NXPHoverGames/MR-KICAD-LIB/README.md

# MR-KICAD-LIB
Mobile Robotics Kicad Library

[How to add parts to KiCad library](https://nxp1.sharepoint.com/teams/13_1/sanda/SAprojects/ItsDemo/_layouts/OneNote.aspx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{2BCBB6BE-1A13-4EB3-B8AA-A23AA9CD01C0}&page-id={D88BF4C9-4BAD-4BB1-8851-3DFD9DD9CD87}&end)
