NXPHoverGames/MR-KICAD-LIB/3dmodels/P6SMB62CA.STEP

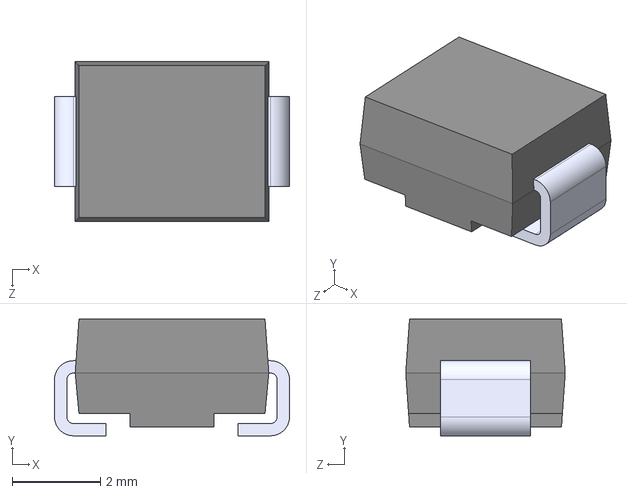
[picture p1: CAD file, 2026-07-27]
3dmodels/P6SMB62CA.STEP
5.34 x 2.65 x 3.62 mm
