NXPHoverGames/MR-KICAD-LIB/3dmodels/NFM15PC104R1A3D.STEP

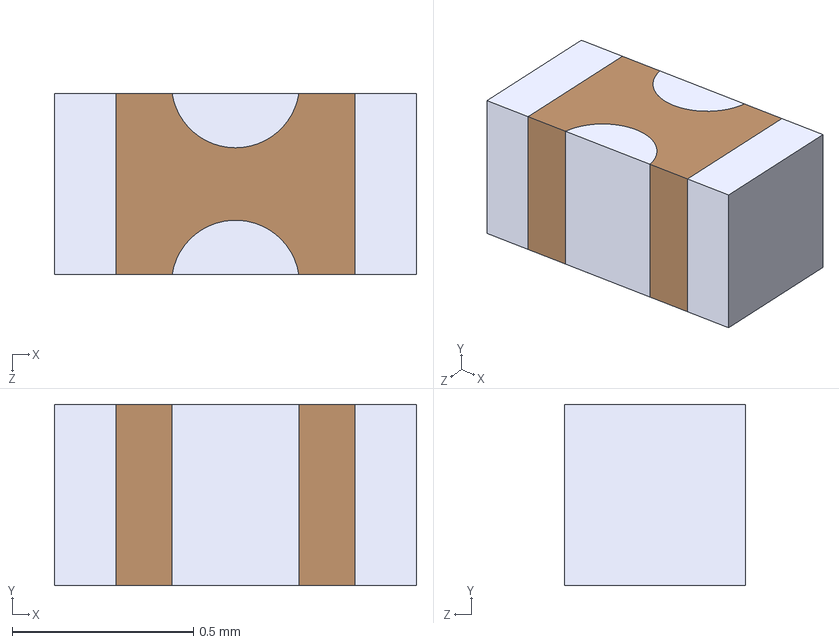
[picture p2: CAD file, 2025-10-23]
3dmodels/NFM15PC104R1A3D.STEP
1.00 x 0.5 x 0.5 mm
