NXPHoverGames/MR-KICAD-LIB/3dmodels/NX138BKMYL.STEP

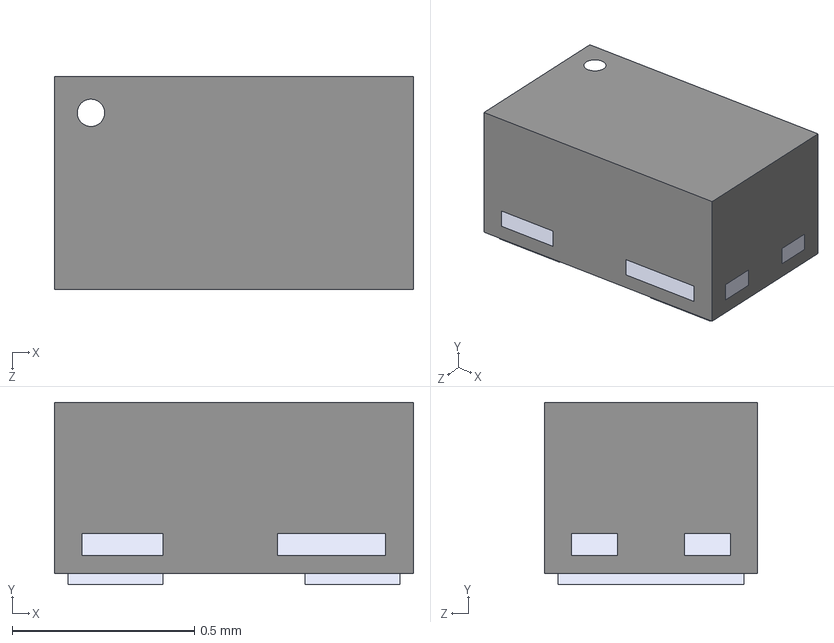
[picture p3: CAD file, 2025-10-23]
3dmodels/NX138BKMYL.STEP
0.985 x 0.5 x 0.585 mm
