NXPHoverGames/MR-KICAD-LIB/3dmodels/CHS-01TA.STEP

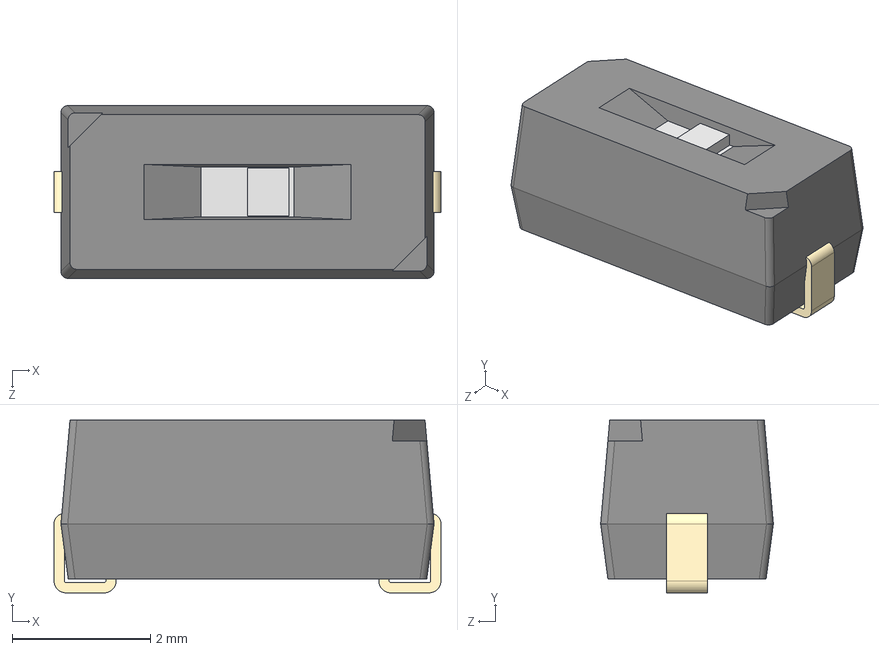
[picture p4: CAD file, 2025-10-23]
3dmodels/CHS-01TA.STEP
5.60 x 2.50 x 2.50 mm
CHS-01 body
pin^CHS-01xx
switch^CHS-01xx
