NXPHoverGames/MR-KICAD-LIB/3dmodels/REF6041IDGKT.stp

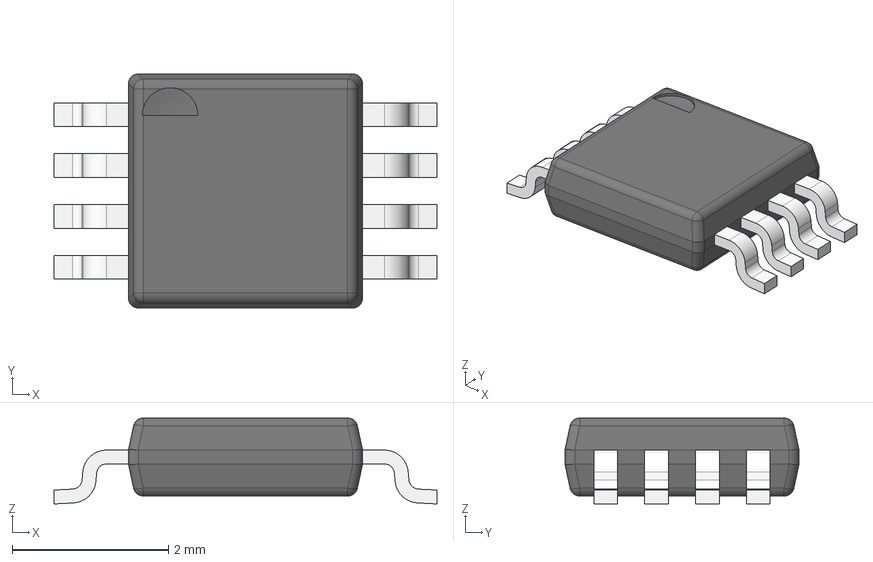
[picture p5: CAD file, 2025-09-09]
3dmodels/REF6041IDGKT.stp
4.90 x 3.00 x 1.10 mm
BODY_MUA08A
LEAD_MUA08A x 8
