NXPHoverGames/MR-KICAD-LIB/3dmodels/THS4551IRGTR.stp

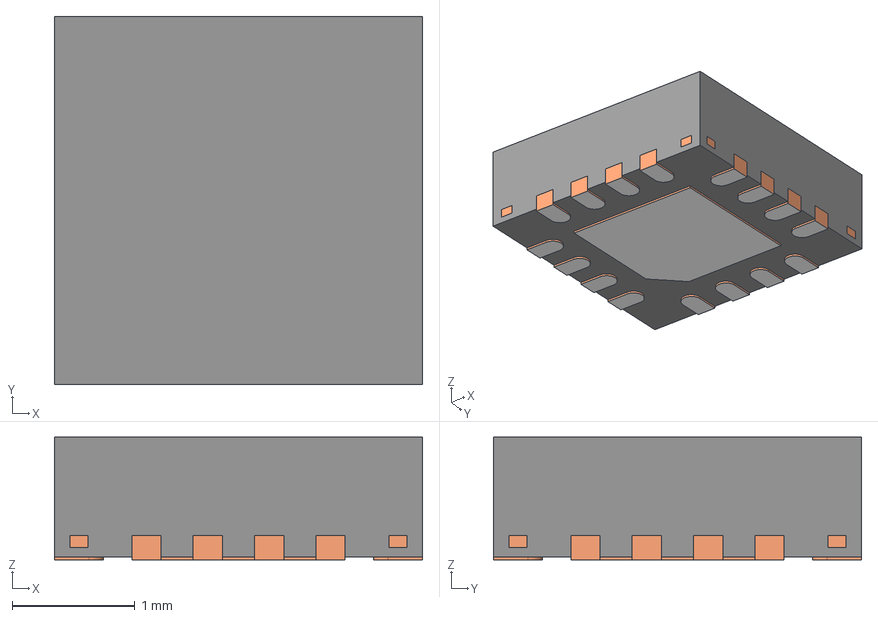
[picture p6: CAD file, 2025-09-09]
3dmodels/THS4551IRGTR.stp
3.00 x 3.00 x 1.00 mm
BODY-QFN
FRAME-RGT0016C
PIN1-ID
