NXPHoverGames/MR-KICAD-LIB/3dmodels/ADS127L18IRSHT.stp

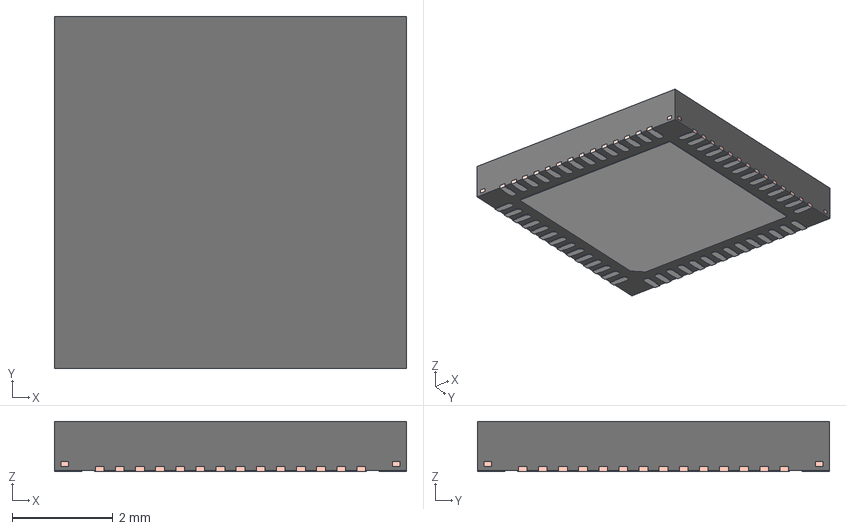
[picture p7: CAD file, 2025-08-08]
3dmodels/ADS127L18IRSHT.stp
7.00 x 7.00 x 1.00 mm
RSH0056G_FRAME
RSH0056G_BODY
RSH0056G_PIN1_AREA
