NXPHoverGames/MR-KICAD-LIB/3dmodels/KRL6432E-M-R003-F-T1.stp

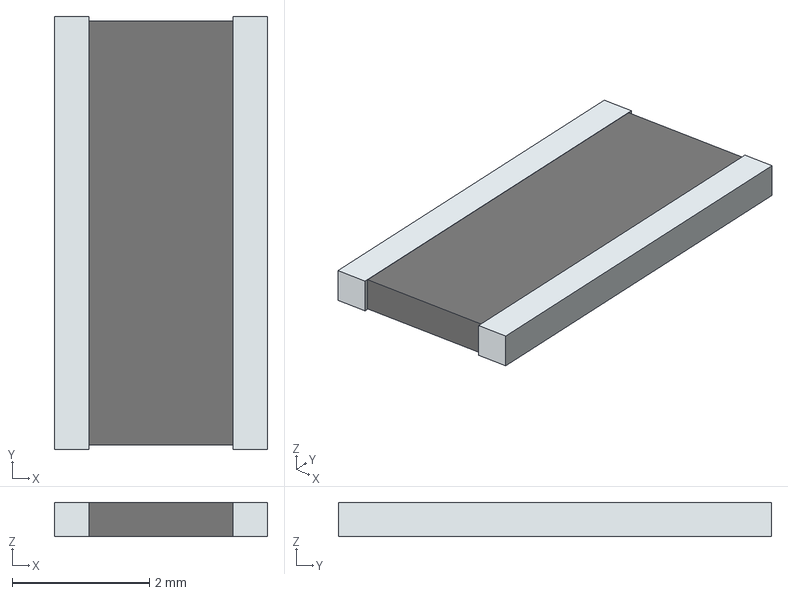
[picture p8: CAD file, 2025-07-31]
3dmodels/KRL6432E-M-R003-F-T1.stp
3.10 x 6.30 x 0.5 mm
term1
term2
