NXPHoverGames/MR-KICAD-LIB/3dmodels/MDT275M02001.stp

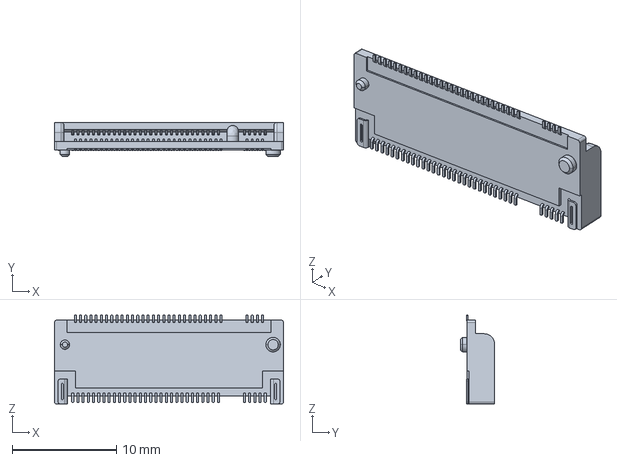
[picture p9: CAD file, 2025-07-31]
3dmodels/MDT275M02001.stp
22.0 x 3.30 x 8.55 mm
