NXPHoverGames/MR-KICAD-LIB/3dmodels/21x21.960-21-21-D-AB-0.STEP

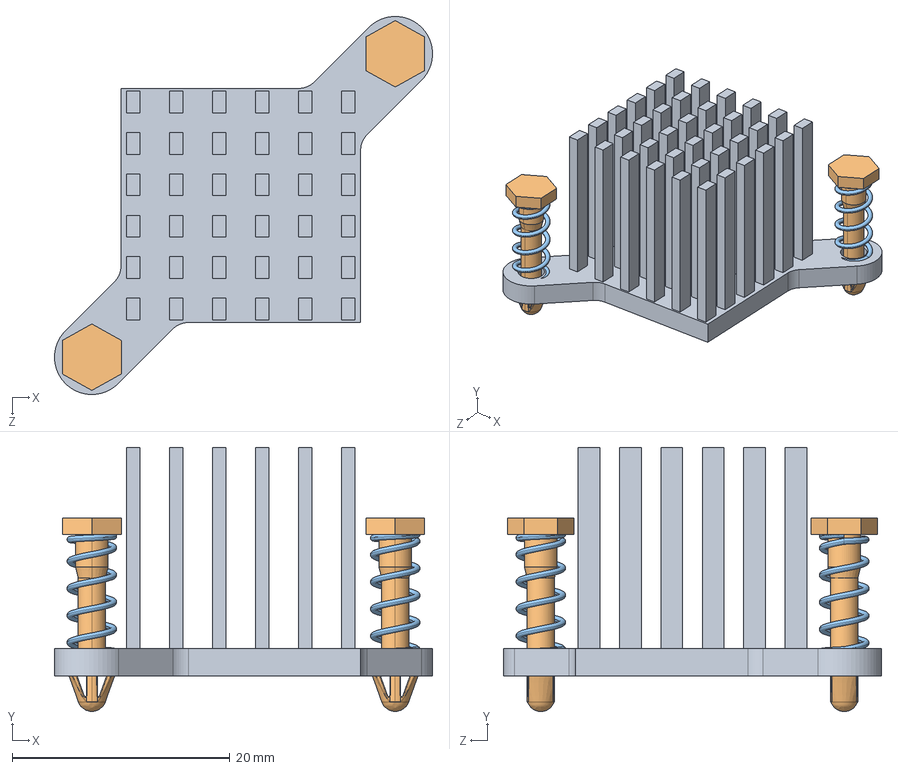
[picture p10: CAD file, 2025-07-31]
3dmodels/21x21.960-21-21-D-AB-0.STEP
34.7 x 24.2 x 34.7 mm
21mm_base_21x21 diag ears
Spring_C0180-022-0440-M x 2
