NXPHoverGames/MR-KICAD-LIB/3dmodels/DF40TC-40DP-0.4V(51).stp

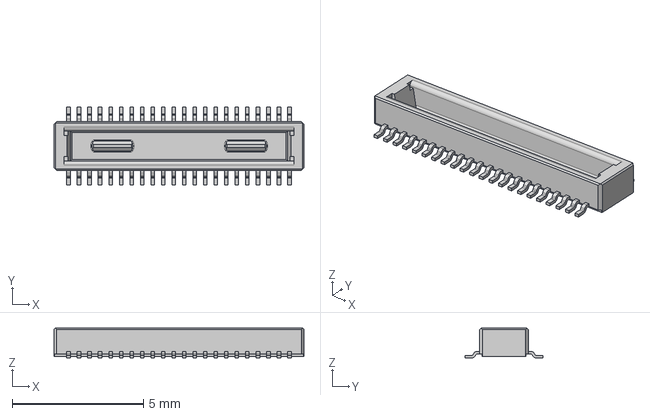
[picture p11: CAD file, 2025-07-31]
3dmodels/DF40TC-40DP-0.4V(51).stp
9.52 x 2.97 x 1.14 mm
