NXPHoverGames/MR-KICAD-LIB/3dmodels/SM10B-SRSS-TB_LF__SN_.stp

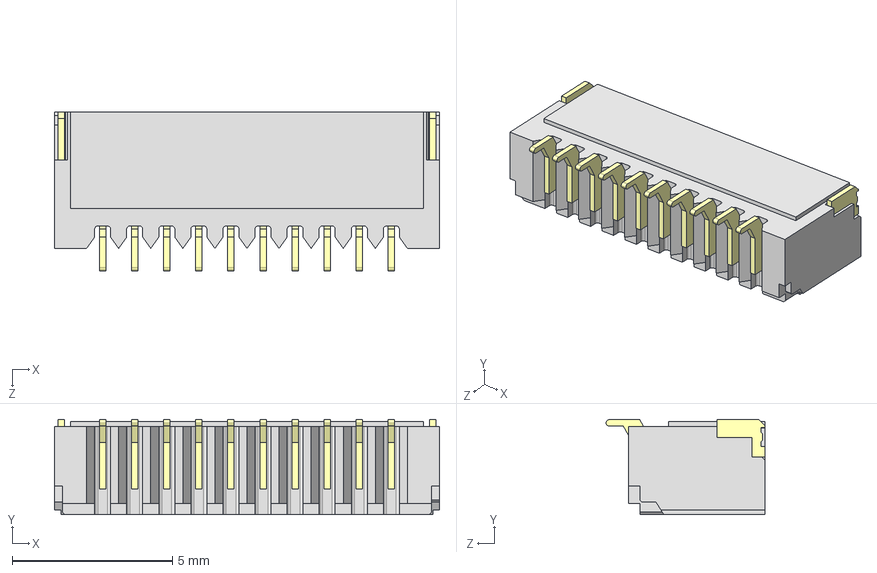
[picture p12: CAD file, 2025-07-31]
3dmodels/SM10B-SRSS-TB_LF__SN_.stp
12.0 x 2.97 x 4.95 mm
