NXPHoverGames/MR-KICAD-LIB/3dmodels/spm4030.step

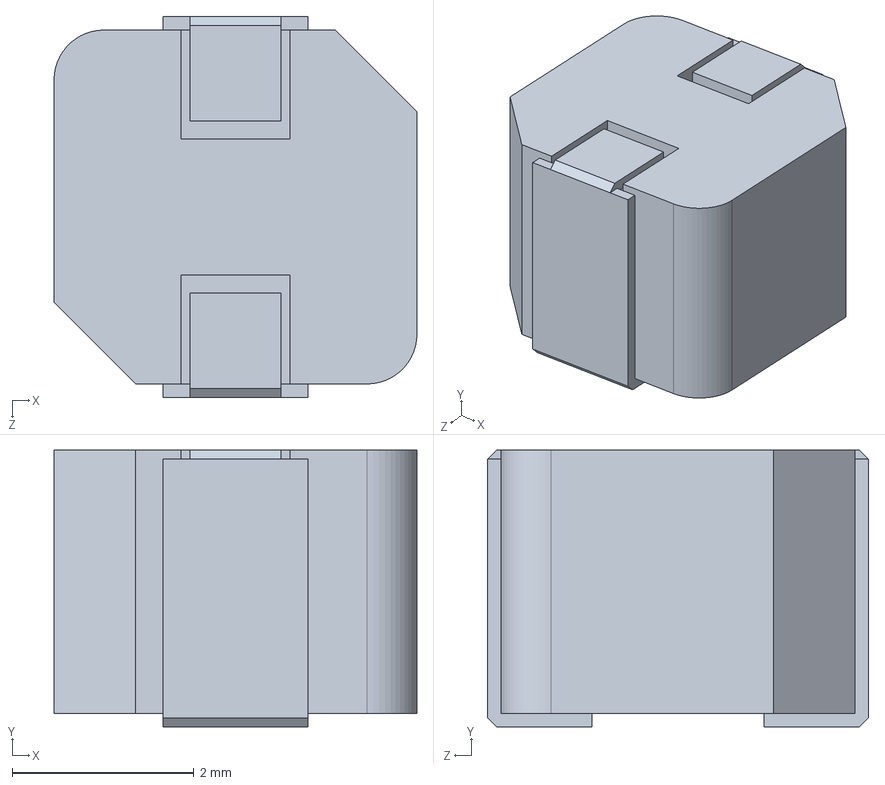
[picture p13: CAD file, 2025-07-31]
3dmodels/spm4030.step
4.00 x 3.05 x 4.20 mm
