NXPHoverGames/MR-KICAD-LIB/3dmodels/EPC2204A.step

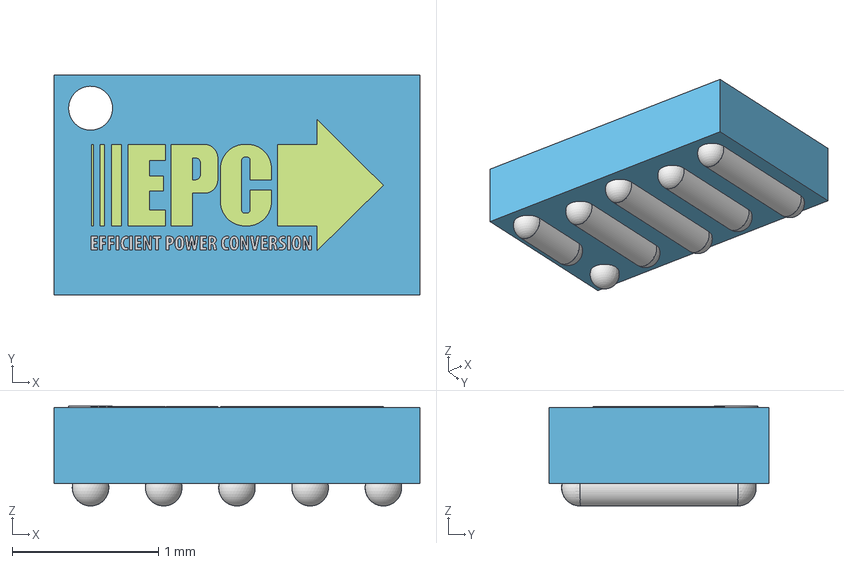
[picture p14: CAD file, 2025-07-31]
3dmodels/EPC2204A.step
2.50 x 1.50 x 0.683 mm
2mm
2mm001
2mm002
2mm003
2mm004
2mm005
2mm006
Extruded
