NXPHoverGames/MR-KICAD-LIB/3dmodels/STEP_61612102121405 (rev1).stp

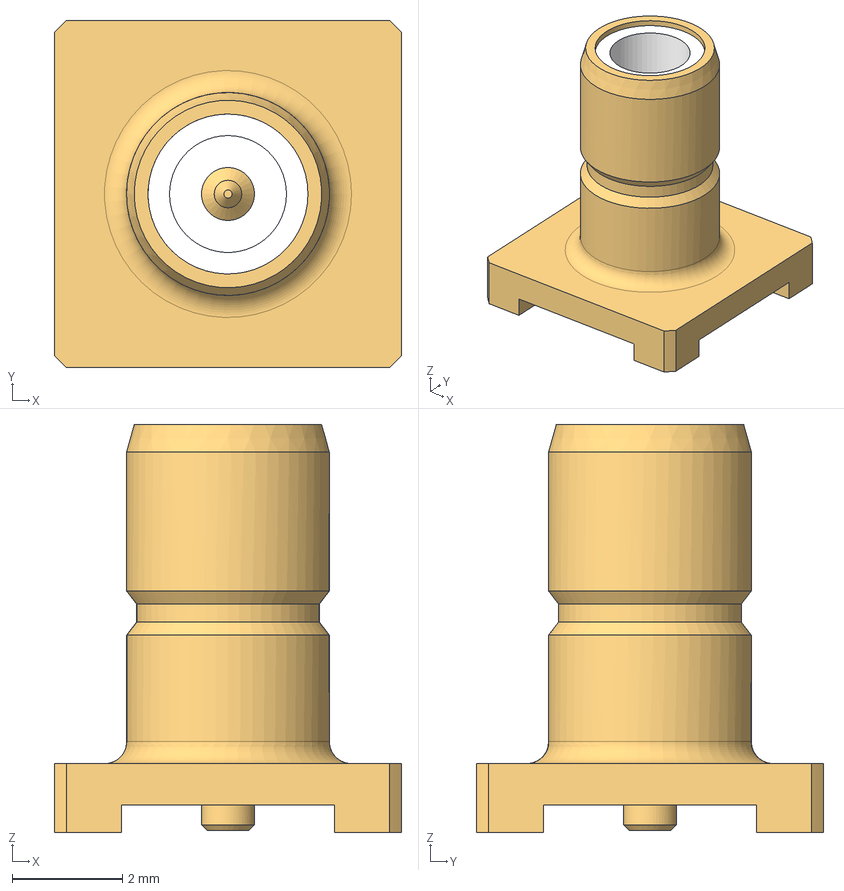
[picture p15: CAD file, 2025-07-31]
3dmodels/STEP_61612102121405 (rev1).stp
6.30 x 6.30 x 7.40 mm
