NXPHoverGames/MR-KICAD-LIB/3dmodels/PESD2IVN24-UX.stp

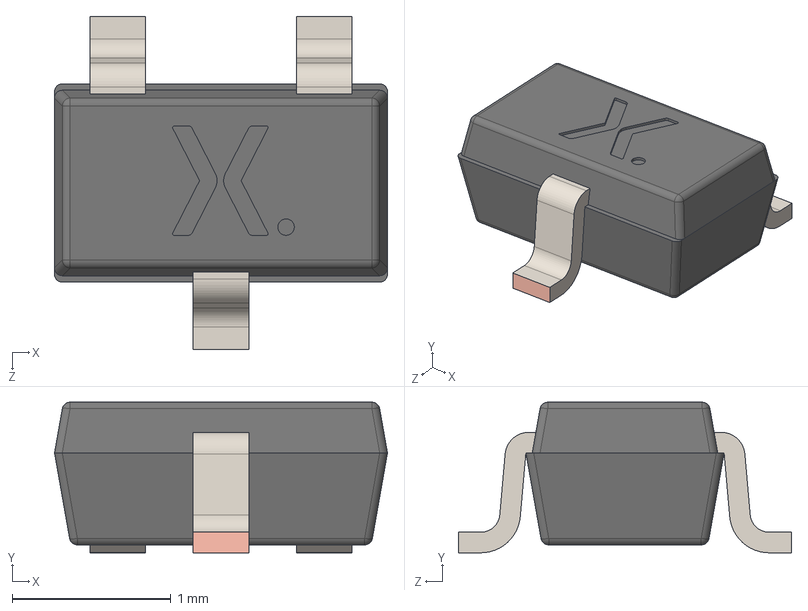
[picture p16: CAD file, 2025-07-31]
3dmodels/PESD2IVN24-UX.stp
2.10 x 0.95 x 2.10 mm
Upper body
lower body
Lead x 3
