NXPHoverGames/MR-KICAD-LIB/3dmodels/TCR3UF20A_LM_CT.step

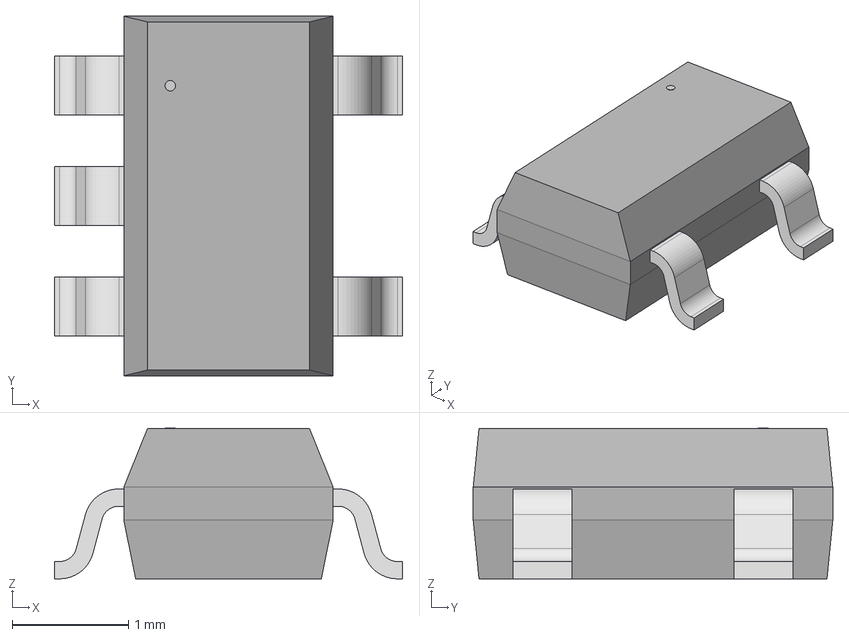
[picture p17: CAD file, 2025-07-31]
3dmodels/TCR3UF20A_LM_CT.step
3.00 x 3.10 x 1.30 mm
