NXPHoverGames/MR-KICAD-LIB/3dmodels/PCMF1USB3SZ.stp

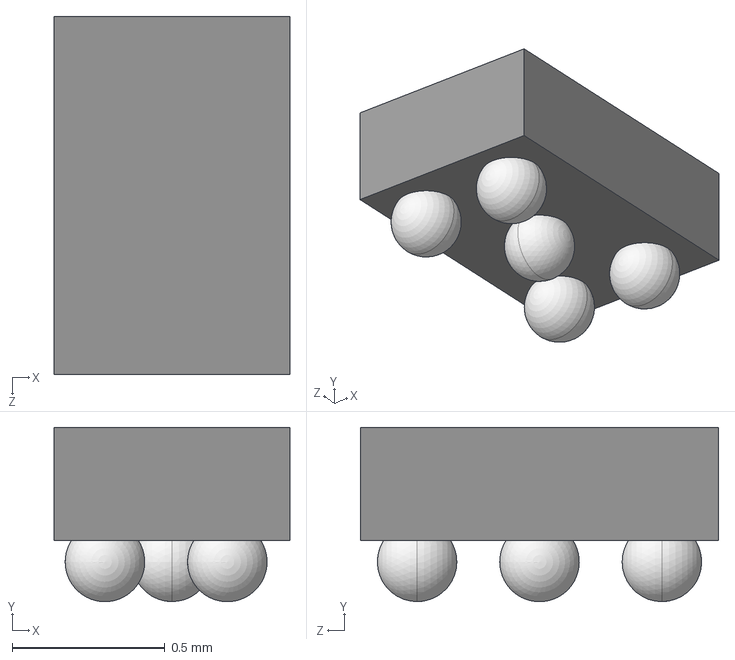
[picture p18: CAD file, 2025-07-31]
3dmodels/PCMF1USB3SZ.stp
0.77 x 0.57 x 1.17 mm
