NXPHoverGames/MR-KICAD-LIB/3dmodels/SIR626LDP-T1-RE3.stp

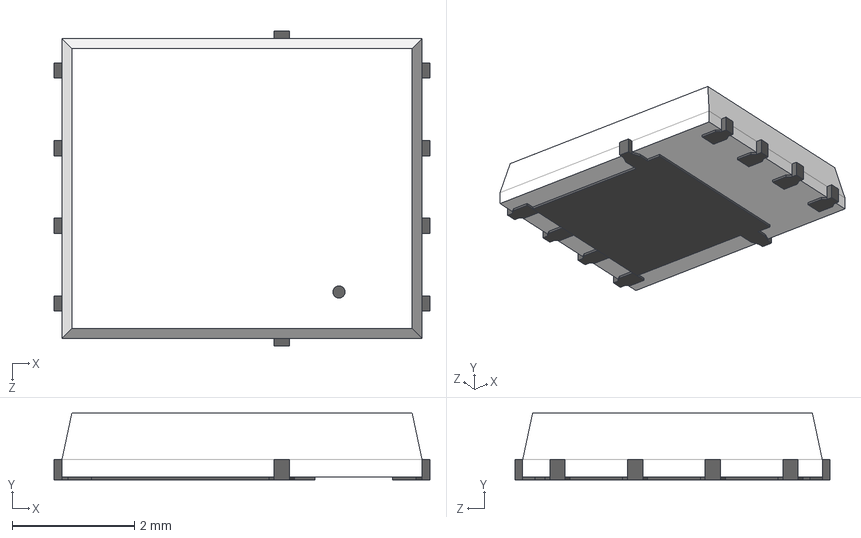
[picture p19: CAD file, 2025-07-31]
3dmodels/SIR626LDP-T1-RE3.stp
6.15 x 1.09 x 5.15 mm
