NXPHoverGames/MR-KICAD-LIB/3dmodels/PG-TSDSON-8-25_Z8B00157108_V02_3D.stp

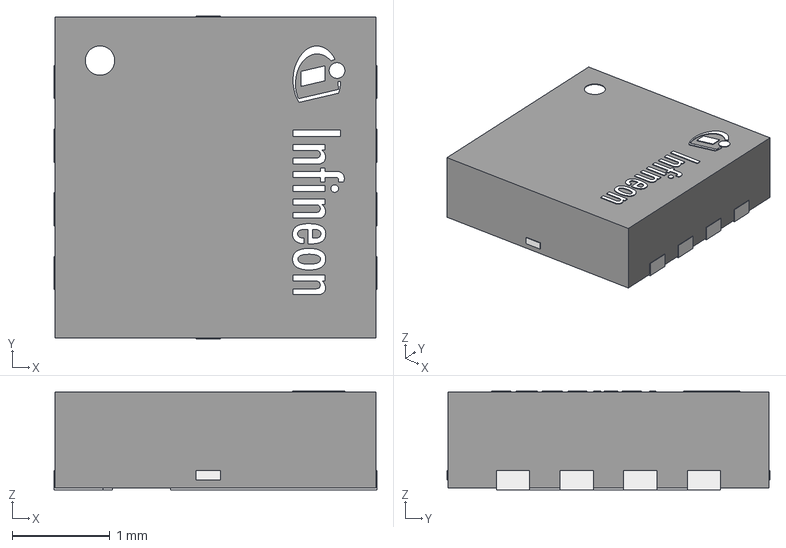
[picture p20: CAD file, 2025-07-31]
3dmodels/PG-TSDSON-8-25_Z8B00157108_V02_3D.stp
3.30 x 3.30 x 1.01 mm
