NXPHoverGames/MR-KICAD-LIB/3dmodels/DF40TC-40DS-0.4V_58_.stp

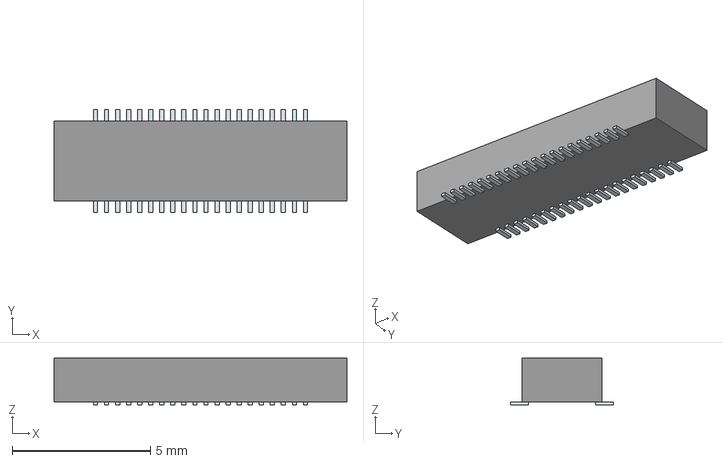
[picture p21: CAD file, 2025-07-31]
3dmodels/DF40TC-40DS-0.4V_58_.stp
10.6 x 3.74 x 1.70 mm
Pins
