NXPHoverGames/MR-KICAD-LIB/3dmodels/LM5143QRHARQ1.stp

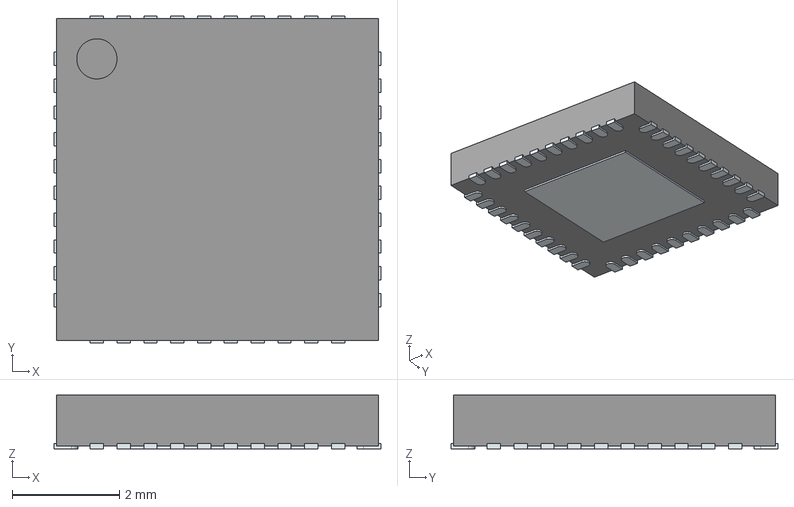
[picture p22: CAD file, 2025-07-31]
3dmodels/LM5143QRHARQ1.stp
6.10 x 6.10 x 1.00 mm
ThermalPin
PinsArrayLR
PinsArrayTB
