NXPHoverGames/MR-KICAD-LIB/3dmodels/XRCGB25M000F3A00R0.stp

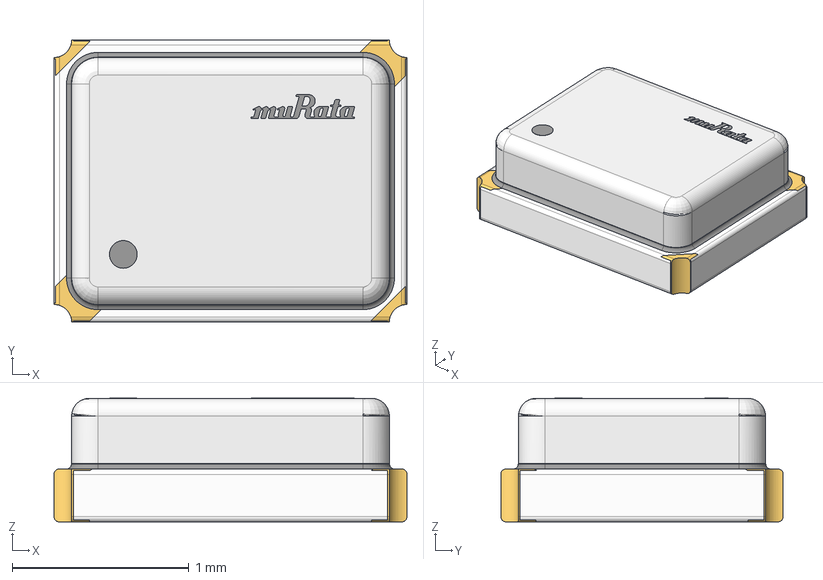
[picture p24: CAD file, 2025-07-31]
3dmodels/XRCGB25M000F3A00R0.stp
2.00 x 1.60 x 0.702 mm
