NXPHoverGames/MR-KICAD-LIB/3dmodels/6DFN62CA-M3_I.stp

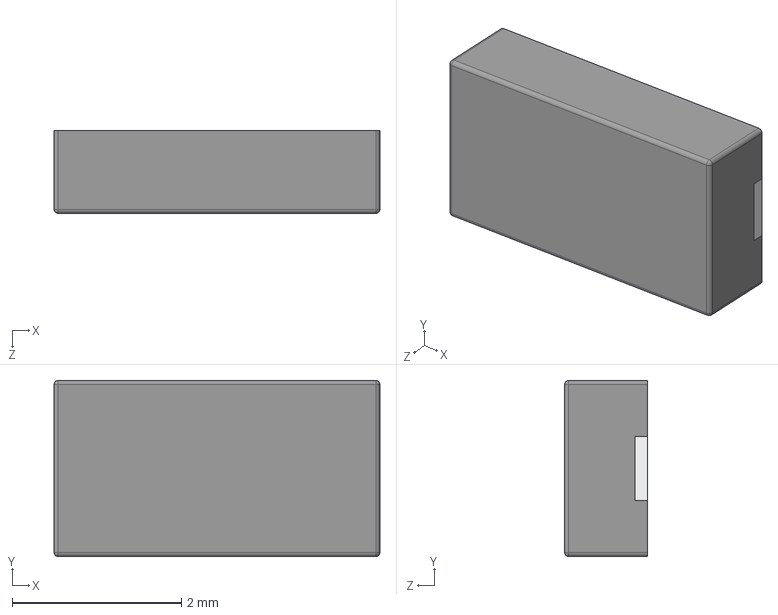
[picture p25: CAD file, 2025-07-31]
3dmodels/6DFN62CA-M3_I.stp
3.85 x 2.08 x 0.98 mm
