NXPHoverGames/MR-KICAD-LIB/3dmodels/F32Q-1A7H1-11022.stp

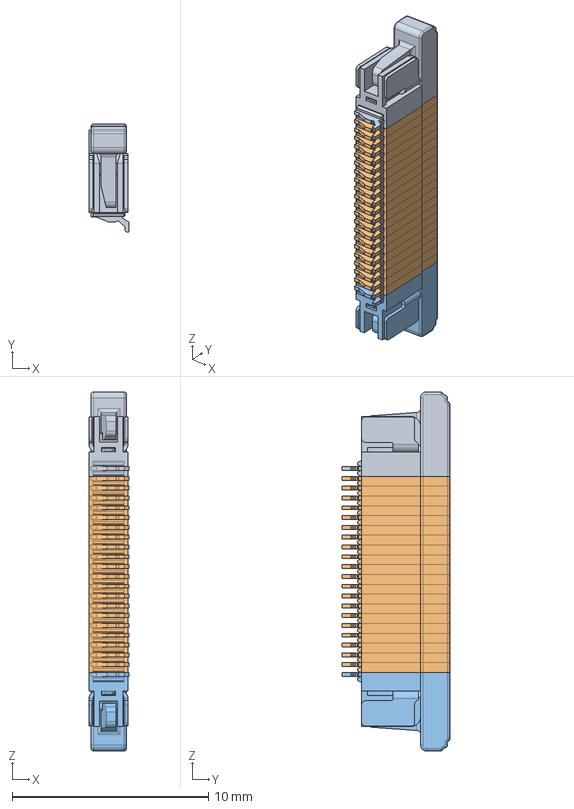
[picture p26: CAD file, 2025-07-31]
3dmodels/F32Q-1A7H1-11022.stp
2.05 x 5.50 x 18.3 mm
F32Q_L
F32Q_M x 20
F32Q_R
