NXPHoverGames/MR-KICAD-LIB/3dmodels/MIC5504-1.8YMT-TR.step

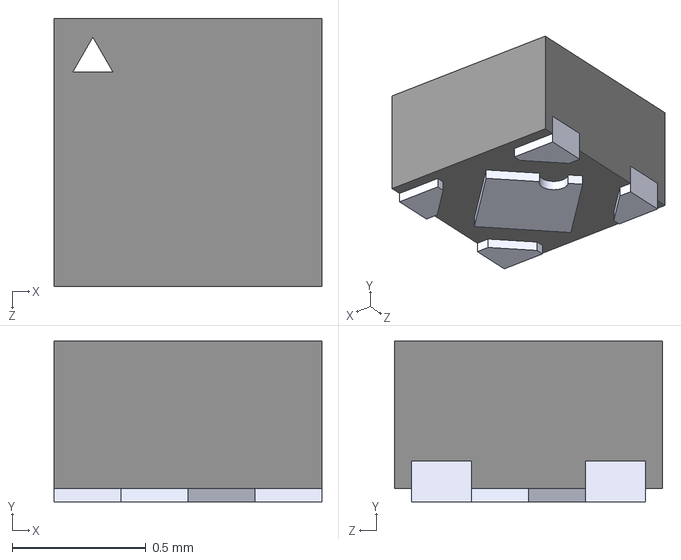
[picture p27: CAD file, 2025-07-31]
3dmodels/MIC5504-1.8YMT-TR.step
1.00 x 0.6 x 1.00 mm
