NXPHoverGames/MR-KICAD-LIB/3dmodels/1-1734248-5.stp

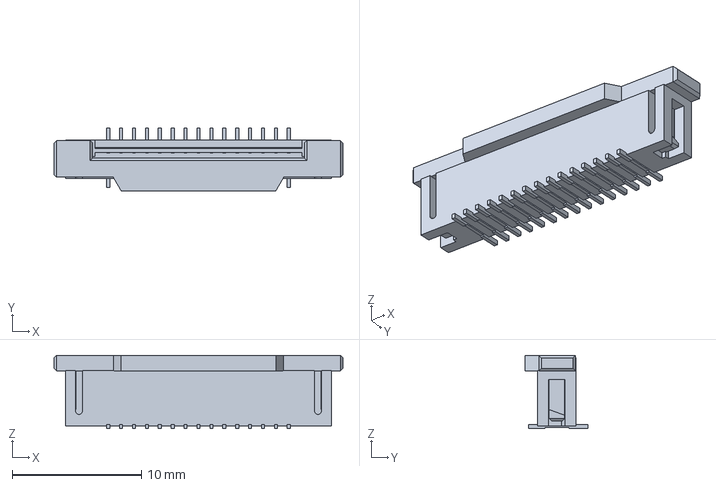
[picture p28: CAD file, 2025-07-31]
3dmodels/1-1734248-5.stp
22.4 x 4.85 x 5.68 mm
