NXPHoverGames/MR-KICAD-LIB/3dmodels/NX5P3363UKZ.stp

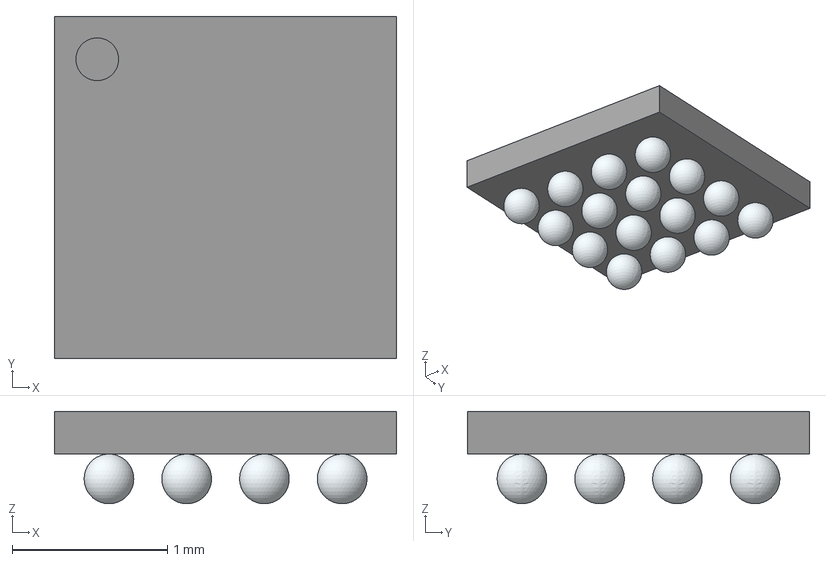
[picture p29: CAD file, 2025-07-31]
3dmodels/NX5P3363UKZ.stp
2.20 x 2.20 x 0.595 mm
