NXPHoverGames/MR-KICAD-LIB/3dmodels/NANOT160AS.stp

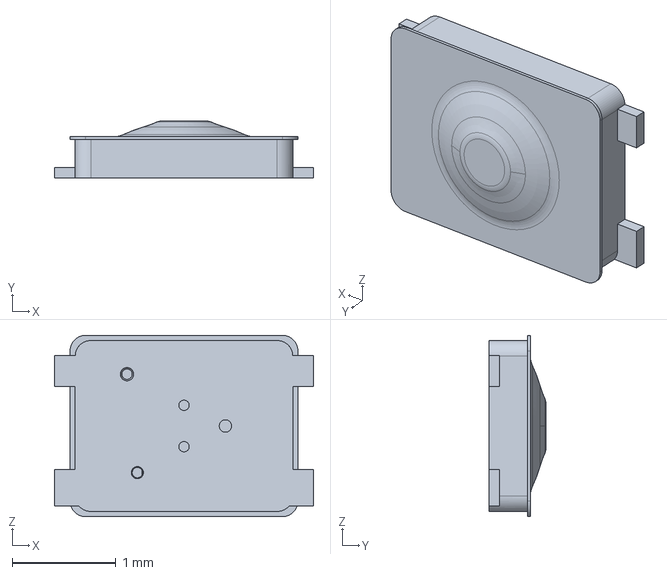
[picture p30: CAD file, 2025-07-31]
3dmodels/NANOT160AS.stp
2.50 x 0.55 x 1.75 mm
