NXPHoverGames/MR-KICAD-LIB/3dmodels/PCMF3USB3S_CZ.stp

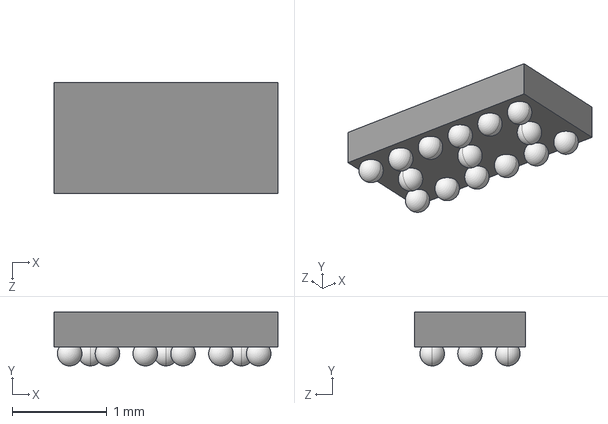
[picture p31: CAD file, 2025-07-31]
3dmodels/PCMF3USB3S_CZ.stp
2.37 x 0.57 x 1.17 mm
