NXPHoverGames/MR-KICAD-LIB/3dmodels/MPM3822CGRH.step

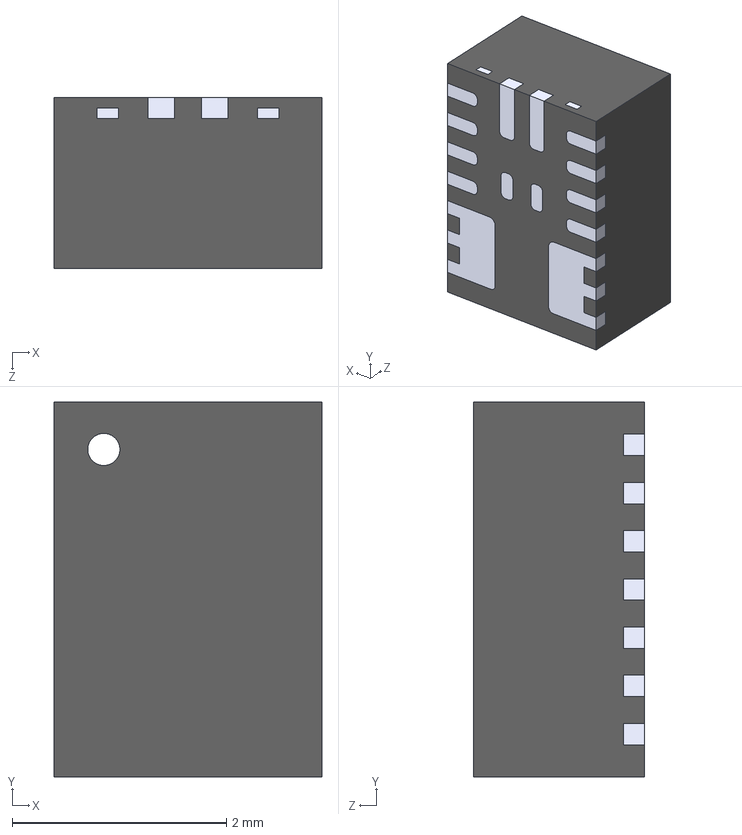
[picture p32: CAD file, 2025-07-31]
3dmodels/MPM3822CGRH.step
2.50 x 3.50 x 1.60 mm
