NXPHoverGames/MR-KICAD-LIB/3dmodels/TJA1051TK.step

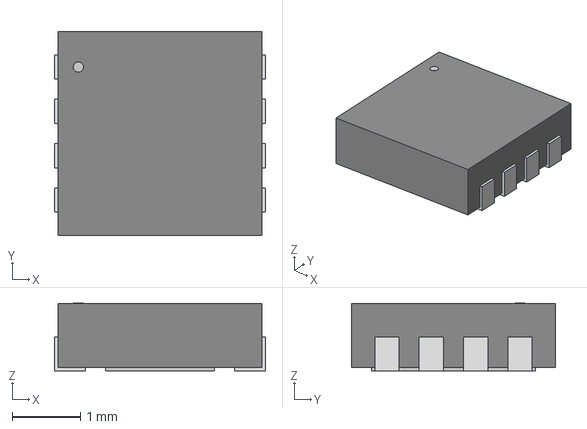
[picture p34: CAD file, 2025-07-31]
3dmodels/TJA1051TK.step
3.10 x 3.00 x 0.993 mm
