NXPHoverGames/MR-KICAD-LIB/3dmodels/SM06B-GHS-TB_LF__SN_.stp

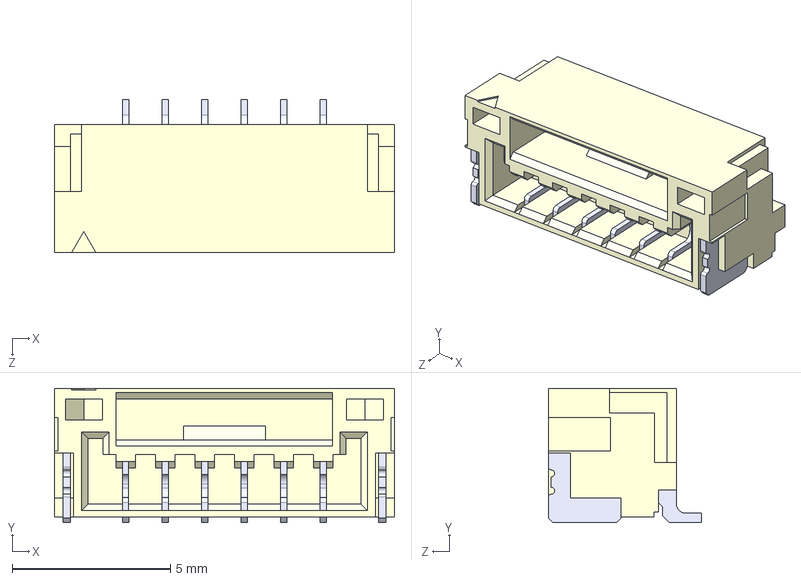
[picture p35: CAD file, 2025-07-31]
3dmodels/SM06B-GHS-TB_LF__SN_.stp
10.8 x 4.25 x 4.85 mm
