NXPHoverGames/MR-KICAD-LIB/3dmodels/AMS29D-40MZ5-Z.stp

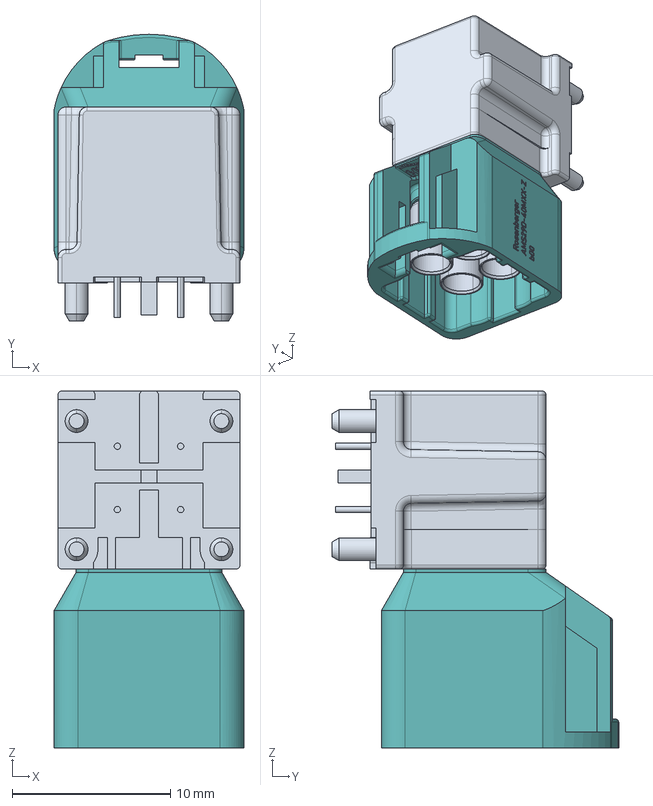
[picture p36: CAD file, 2025-07-31]
3dmodels/AMS29D-40MZ5-Z.stp
12.0 x 18.1 x 22.6 mm
