NXPHoverGames/MR-KICAD-LIB/3dmodels/ICM-42688-P0.step

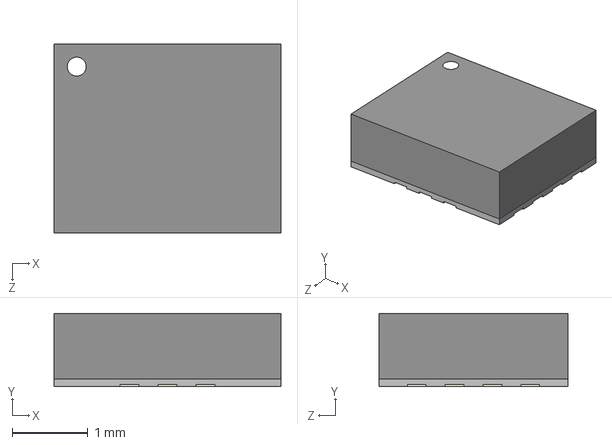
[picture p37: CAD file, 2025-07-31]
3dmodels/ICM-42688-P0.step
3.00 x 0.97 x 2.50 mm
