NXPHoverGames/MR-KICAD-LIB/3dmodels/Infineon-PG-TDSON-8-45_3D_01_STP-Package-v14_00-EN.stp

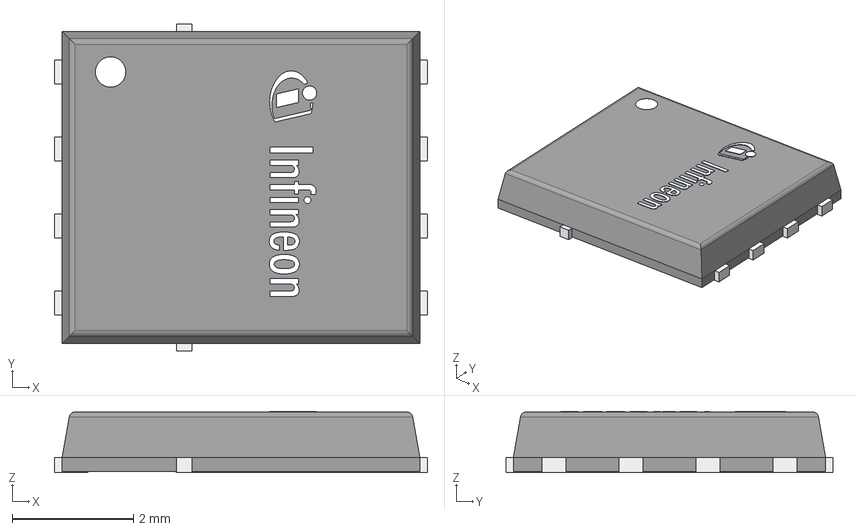
[picture p38: CAD file, 2025-07-31]
3dmodels/Infineon-PG-TDSON-8-45_3D_01_STP-Package-v14_00-EN.stp
6.15 x 5.39 x 1.01 mm
