NXPHoverGames/MR-KICAD-LIB/3dmodels/VQFN32_PHA_MCH.step

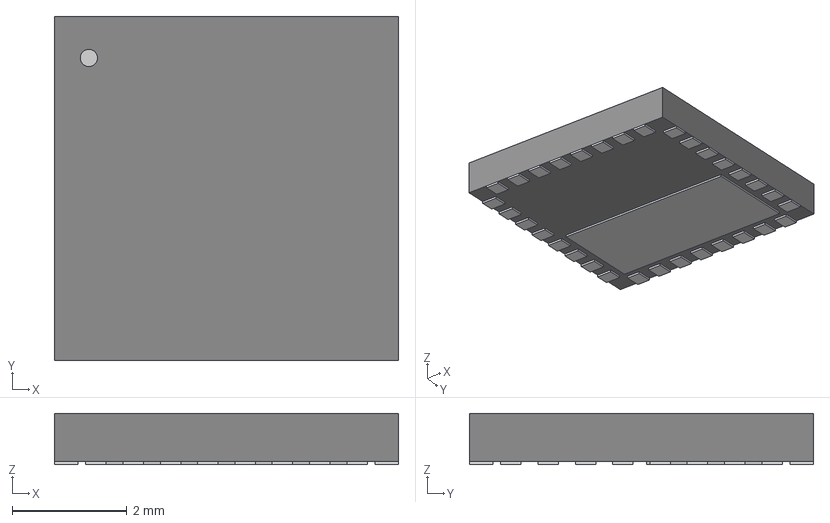
[picture p39: CAD file, 2025-07-31]
3dmodels/VQFN32_PHA_MCH.step
5.99 x 5.99 x 0.892 mm
