NXPHoverGames/MR-KICAD-LIB/3dmodels/DF40TC_3.0_-40DS-0.4V_58_.stp

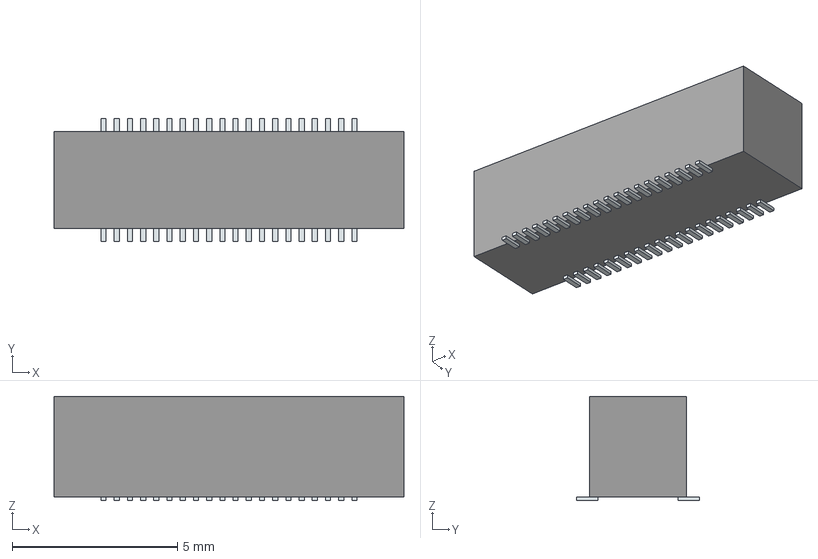
[picture p40: CAD file, 2025-07-31]
3dmodels/DF40TC_3.0_-40DS-0.4V_58_.stp
10.6 x 3.74 x 3.15 mm
Pins
