NXPHoverGames/MR-KICAD-LIB/3dmodels/TSW-108-08-T-T-RA_SAI.step

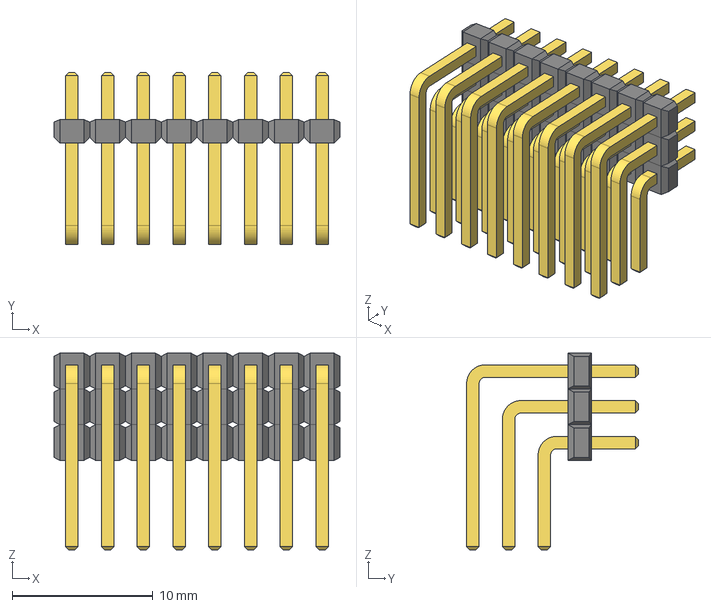
[picture p42: CAD file, 2025-07-31]
3dmodels/TSW-108-08-T-T-RA_SAI.step
20.3 x 12.2 x 14.0 mm
