NXPHoverGames/MR-KICAD-LIB/3dmodels/10LGA_2X2X0p75_BOS.step

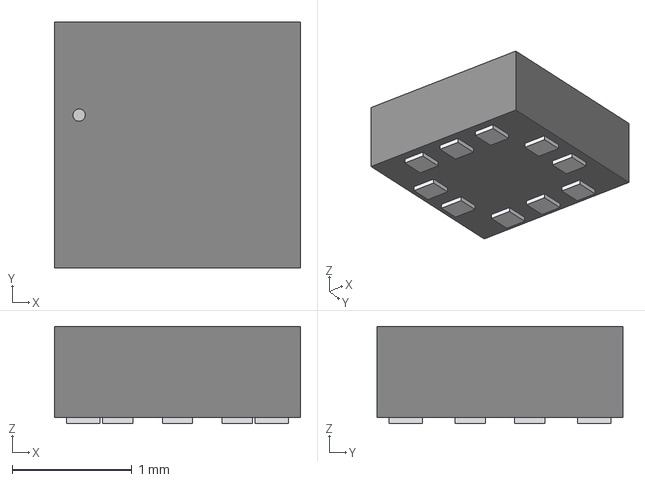
[picture p43: CAD file, 2025-07-31]
3dmodels/10LGA_2X2X0p75_BOS.step
2.06 x 2.06 x 0.815 mm
