NXPHoverGames/MR-KICAD-LIB/3dmodels/BMM350.stp

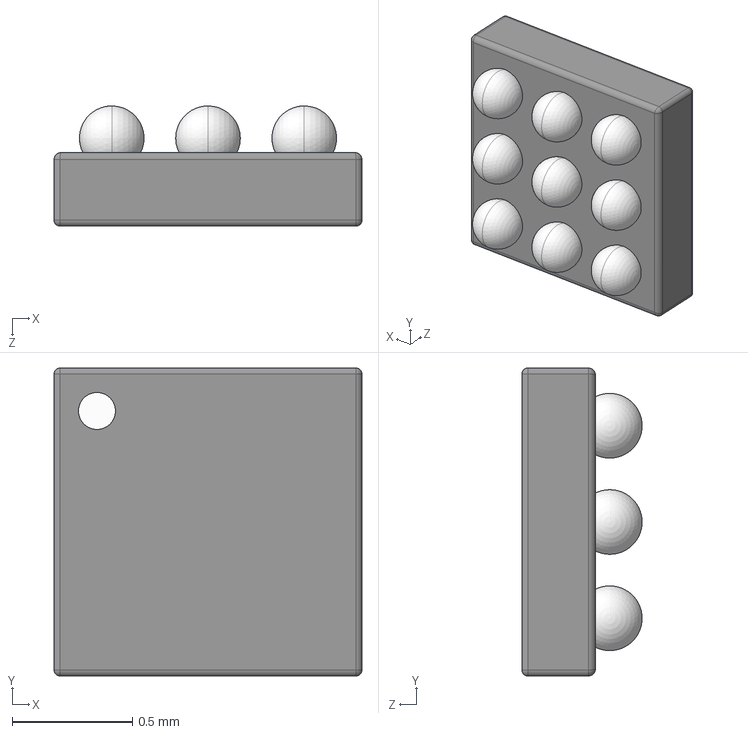
[picture p44: CAD file, 2025-07-31]
3dmodels/BMM350.stp
1.28 x 1.28 x 0.5 mm
