NXPHoverGames/MR-KICAD-LIB/3dmodels/PAA3905E1-Q.STEP

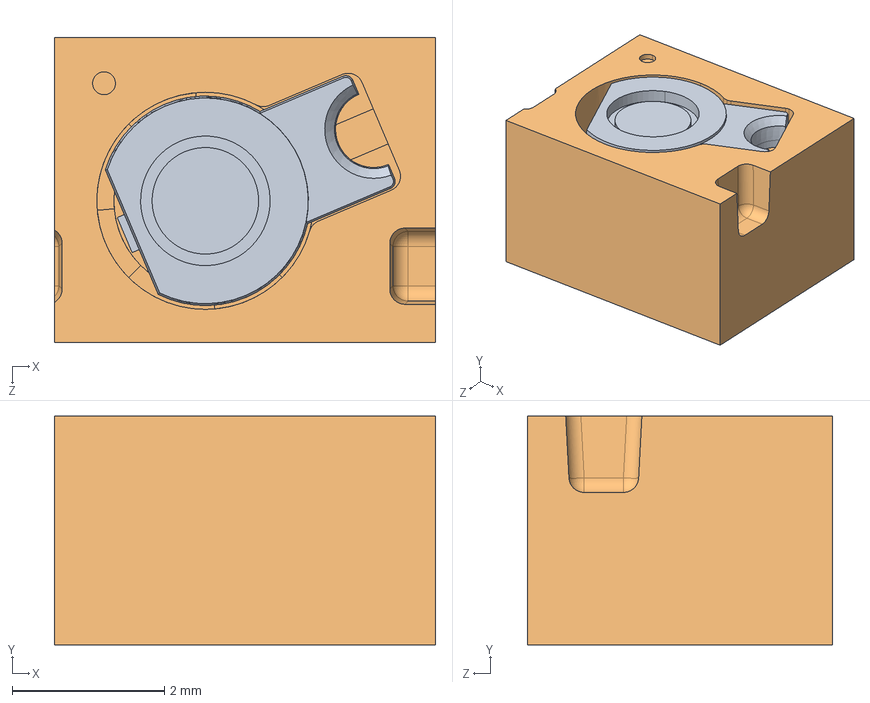
[picture p45: CAD file, 2025-07-31]
3dmodels/PAA3905E1-Q.STEP
5.00 x 3.00 x 4.00 mm
