NXPHoverGames/MR-KICAD-LIB/3dmodels/FH34SRJ-24S-0.5SH_99_.stp

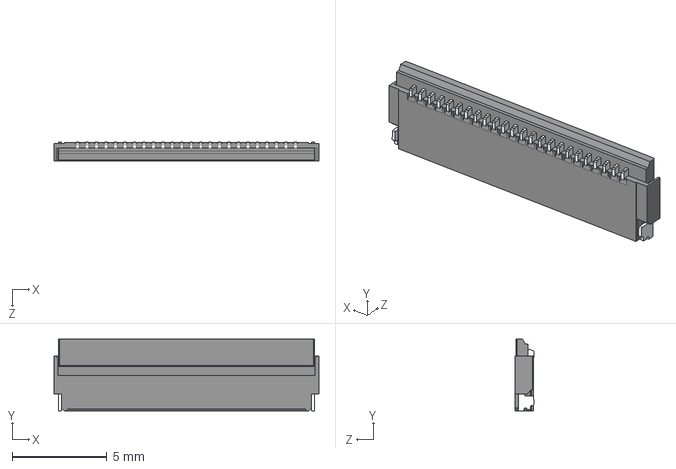
[picture p46: CAD file, 2025-07-31]
3dmodels/FH34SRJ-24S-0.5SH_99_.stp
14.0 x 3.80 x 1.00 mm
