NXPHoverGames/MR-KICAD-LIB/3dmodels/BUK6D56-60EX.stp

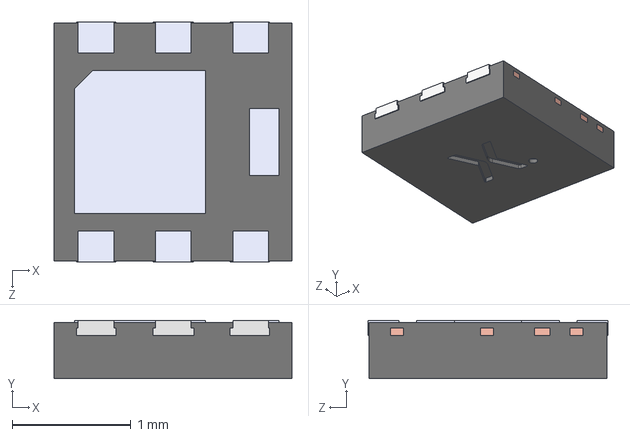
[picture p47: CAD file, 2025-07-31]
3dmodels/BUK6D56-60EX.stp
2.00 x 0.49 x 2.02 mm
SOT1220 Body
SOT1220 Lead
