NXPHoverGames/MR-KICAD-LIB/3dmodels/FKK5R0030FE-TR.stp

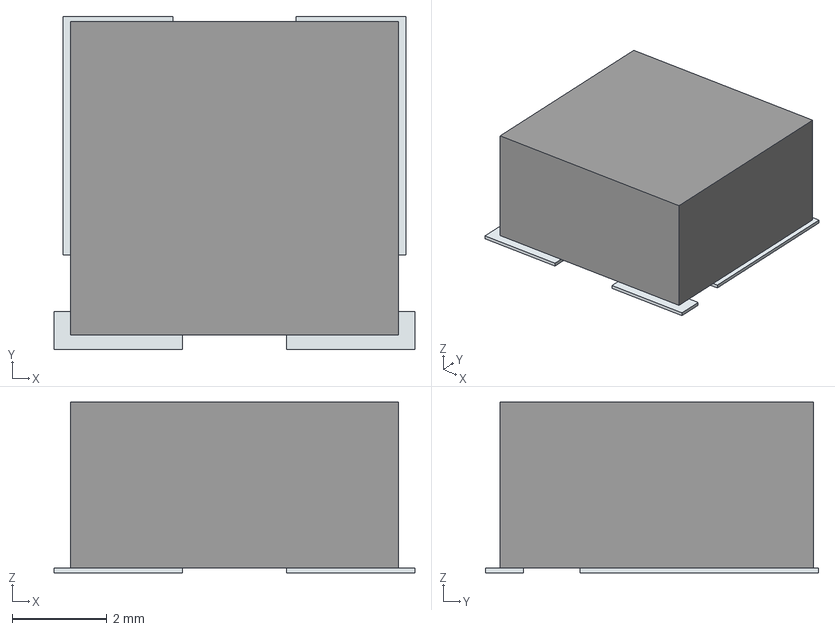
[picture p48: CAD file, 2025-07-31]
3dmodels/FKK5R0030FE-TR.stp
7.60 x 7.01 x 3.60 mm
Pins
