NXPHoverGames/MR-KICAD-LIB/3dmodels/VL53L3CXV0DH.step

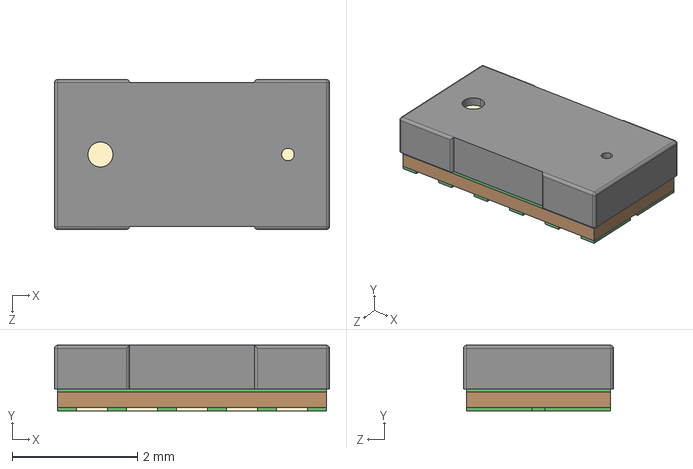
[picture p49: CAD file, 2025-07-31]
3dmodels/VL53L3CXV0DH.step
4.40 x 1.05 x 2.40 mm
