NXPHoverGames/MR-KICAD-LIB/3dmodels/DF40TC(3.0)-50DP-0.4V(51).STEP

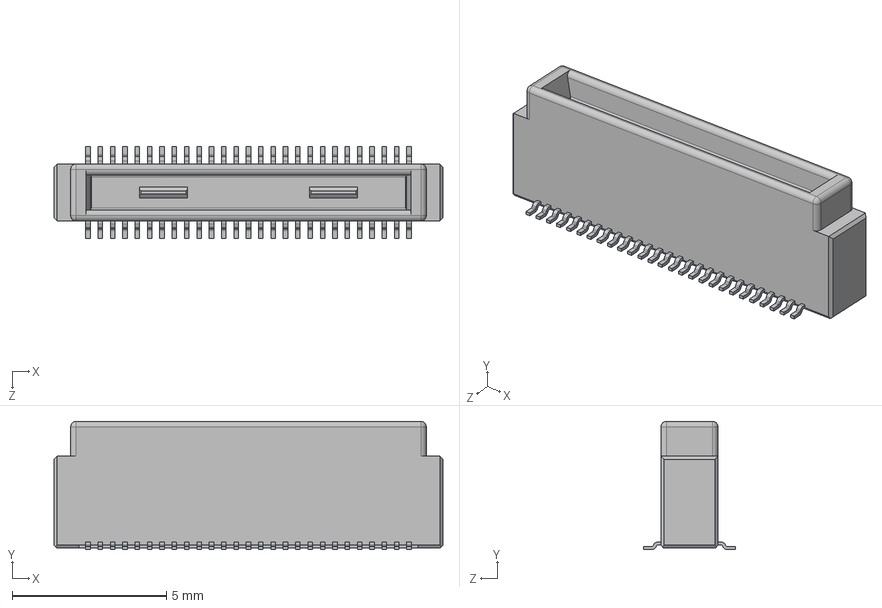
[picture p50: CAD file, 2025-07-31]
3dmodels/DF40TC(3.0)-50DP-0.4V(51).STEP
12.6 x 4.16 x 2.97 mm
