NXPHoverGames/MR-KICAD-LIB/3dmodels/NFM31KC153R1H3L.stp

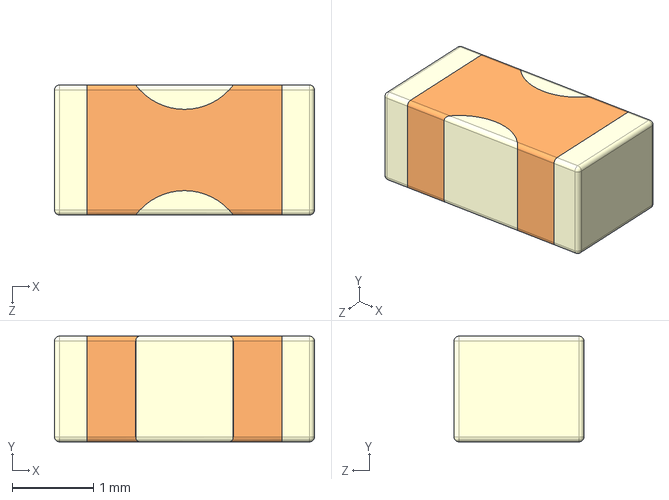
[picture p52: CAD file, 2025-07-31]
3dmodels/NFM31KC153R1H3L.stp
3.20 x 1.30 x 1.60 mm
