NXPHoverGames/MR-KICAD-LIB/3dmodels/VL53L1CXV0FY.step

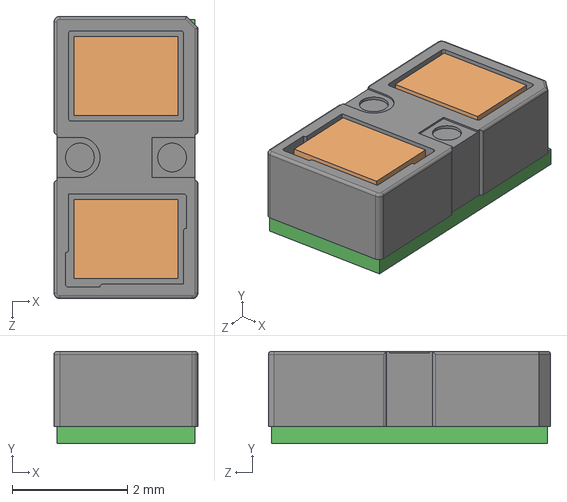
[picture p53: CAD file, 2025-07-31]
3dmodels/VL53L1CXV0FY.step
2.50 x 1.60 x 4.90 mm
