NXPHoverGames/MR-KICAD-LIB/3dmodels/TJA1463ATK.stp

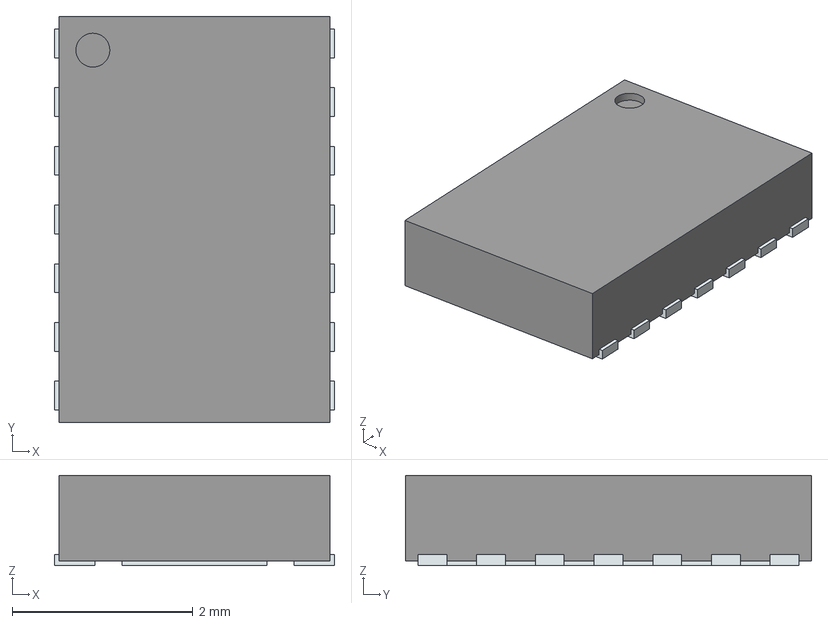
[picture p54: CAD file, 2025-07-31]
3dmodels/TJA1463ATK.stp
3.10 x 4.50 x 1.00 mm
ThermalPin
PinsArrayLR
