NXPHoverGames/MR-KICAD-LIB/3dmodels/Infineon-PG-TTFN-9-3_3D_01_STP-Package-v03_00-EN.stp

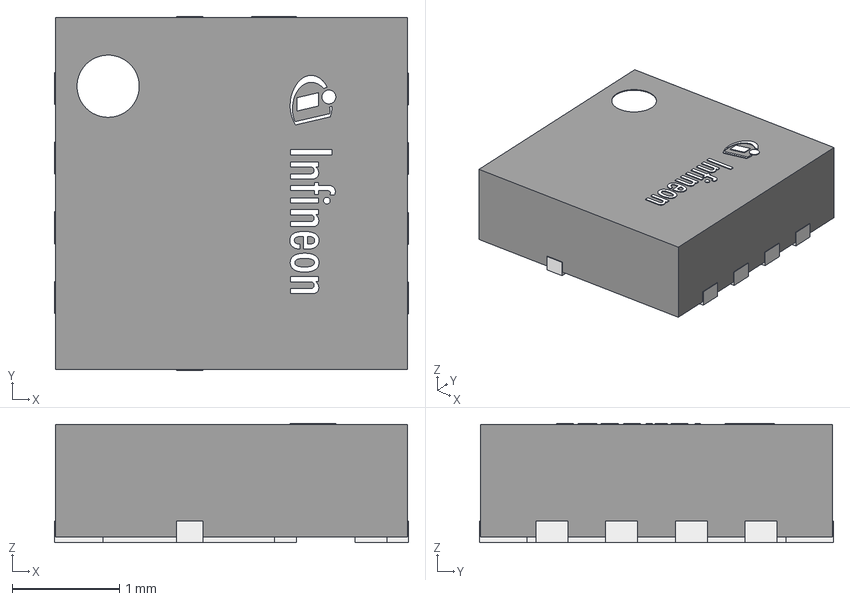
[picture p56: CAD file, 2025-07-31]
3dmodels/Infineon-PG-TTFN-9-3_3D_01_STP-Package-v03_00-EN.stp
3.30 x 3.30 x 1.11 mm
