NXPHoverGames/MR-KICAD-LIB/3dmodels/ICM-42688-P.stp

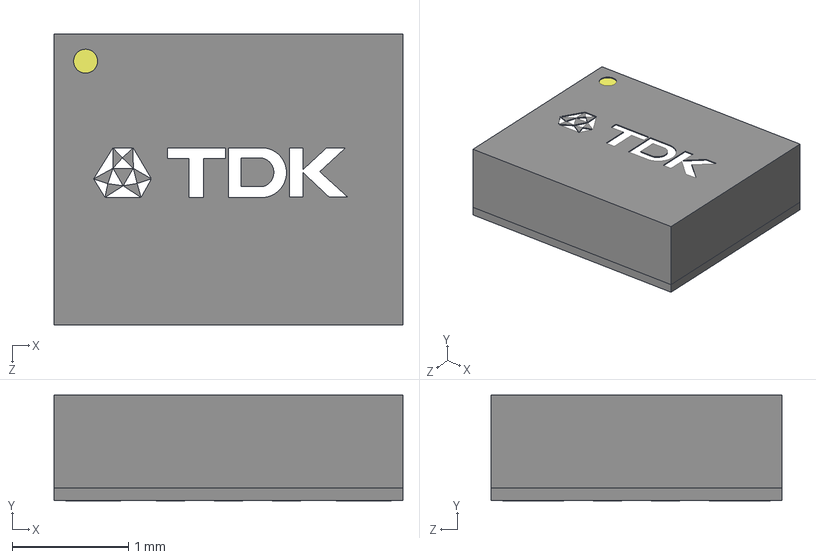
[picture p57: CAD file, 2025-07-31]
3dmodels/ICM-42688-P.stp
3.00 x 0.91 x 2.50 mm
