NXPHoverGames/MR-KICAD-LIB/3dmodels/AFBR-S50xxxxx.step

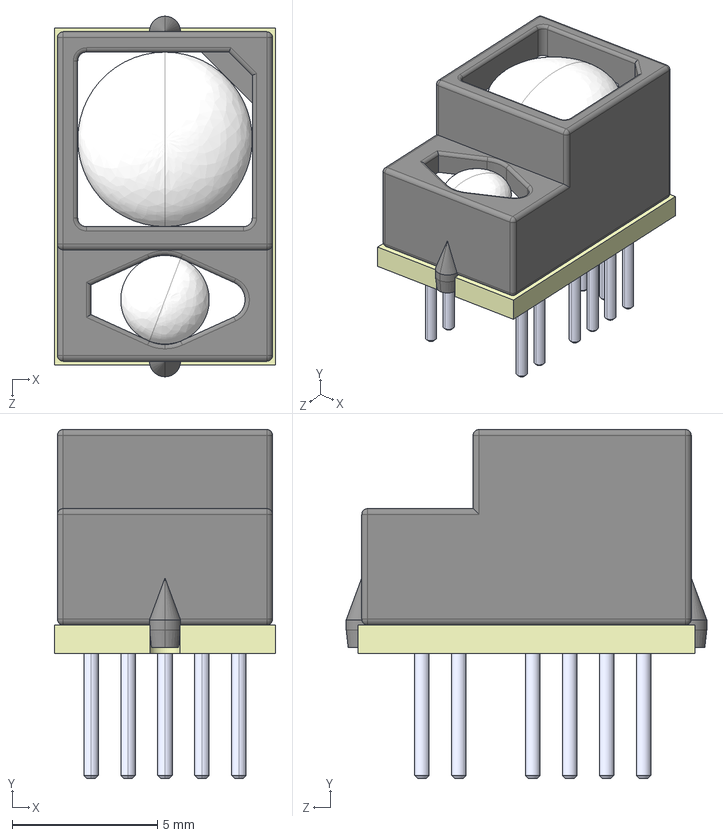
[picture p58: CAD file, 2025-07-31]
3dmodels/AFBR-S50xxxxx.step
7.60 x 12.0 x 12.4 mm
