NXPHoverGames/MR-KICAD-LIB/3dmodels/VL53L8CHV0GC.step

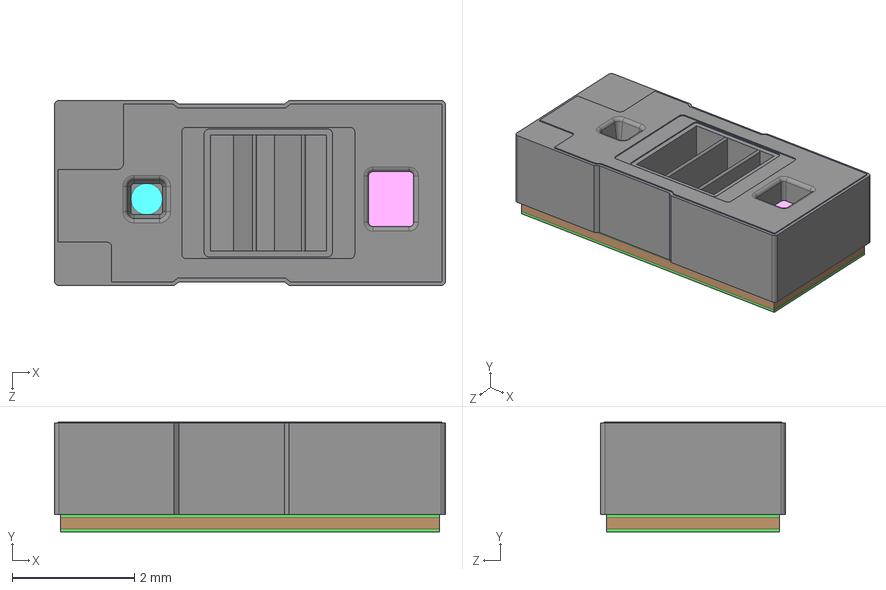
[picture p59: CAD file, 2025-07-31]
3dmodels/VL53L8CHV0GC.step
6.40 x 1.80 x 3.03 mm
