NXPHoverGames/MR-KICAD-LIB/3dmodels/SJA1110AEL_0Y.stp

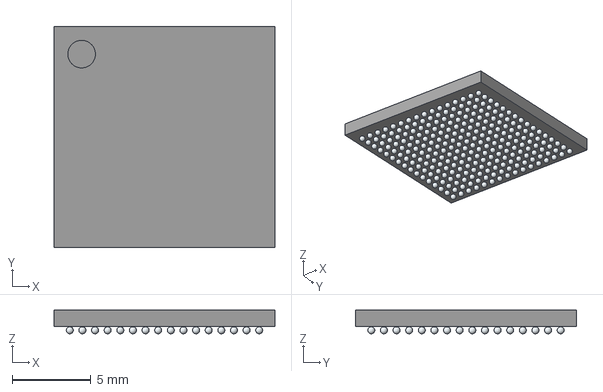
[picture p60: CAD file, 2025-07-31]
3dmodels/SJA1110AEL_0Y.stp
14.0 x 14.0 x 1.50 mm
