NXPHoverGames/MR-KICAD-LIB/3dmodels/BMP581.stp

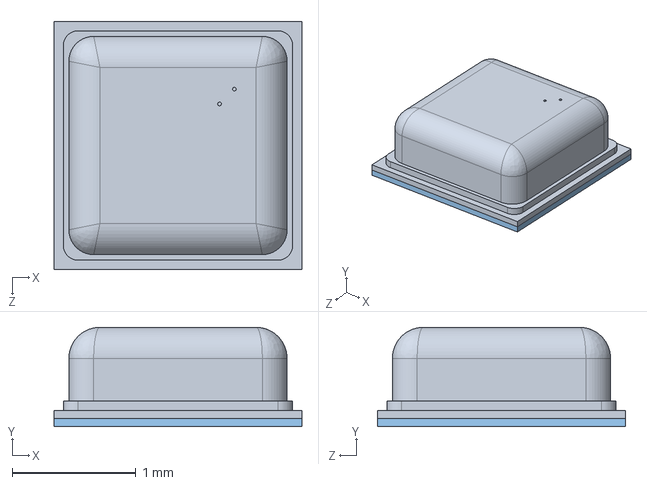
[picture p61: CAD file, 2025-07-31]
3dmodels/BMP581.stp
2.00 x 0.801 x 2.00 mm
