NXPHoverGames/MR-KICAD-LIB/3dmodels/PAA3905.step

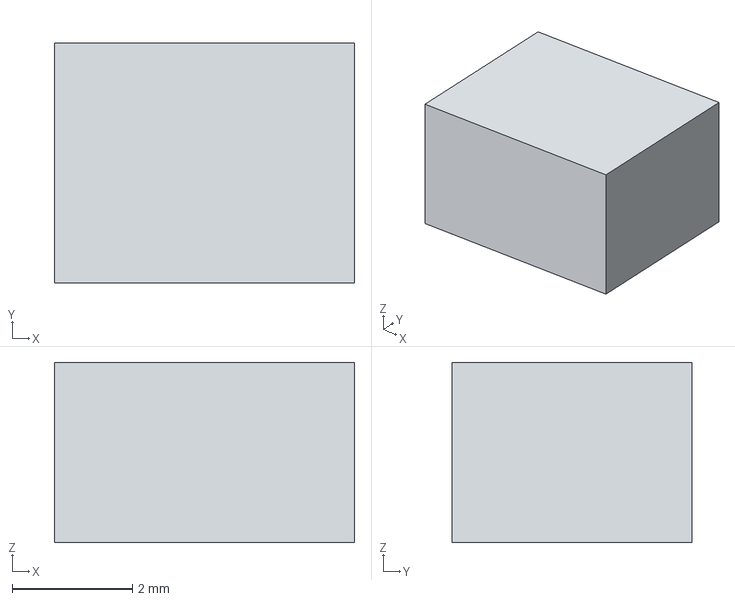
[picture p62: CAD file, 2025-07-31]
3dmodels/PAA3905.step
5.00 x 4.00 x 3.00 mm
