NXPHoverGames/MR-KICAD-LIB/3dmodels/ACT1210L-201-2P-TL00.stp

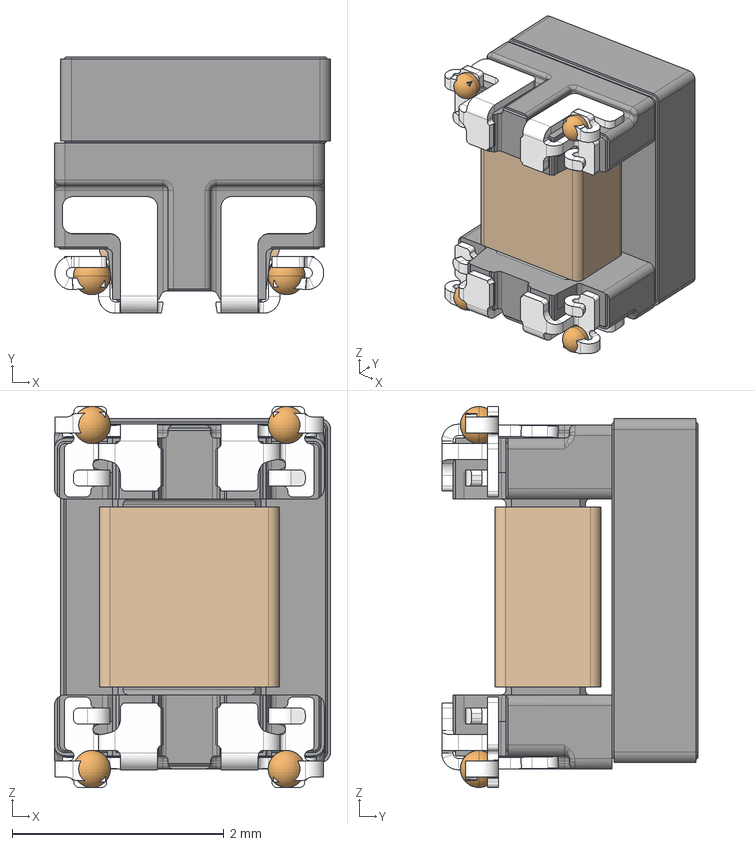
[picture p63: CAD file, 2025-07-31]
3dmodels/ACT1210L-201-2P-TL00.stp
2.61 x 2.42 x 3.60 mm
