NXPHoverGames/MR-KICAD-LIB/3dmodels/TJA1120AHN_0J.stp

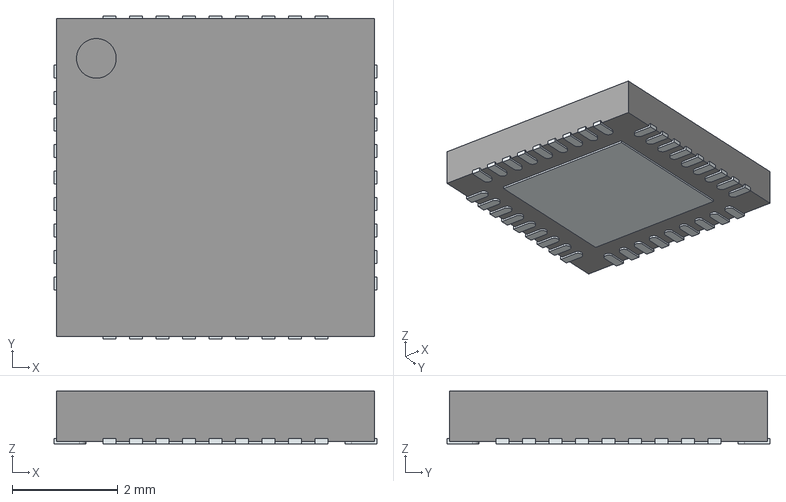
[picture p64: CAD file, 2025-07-31]
3dmodels/TJA1120AHN_0J.stp
6.10 x 6.10 x 1.00 mm
ThermalPin
PinsArrayLR
PinsArrayTB
