NXPHoverGames/MR-KICAD-LIB/3dmodels/HVQFN36_SOT1092-2_NXP.step

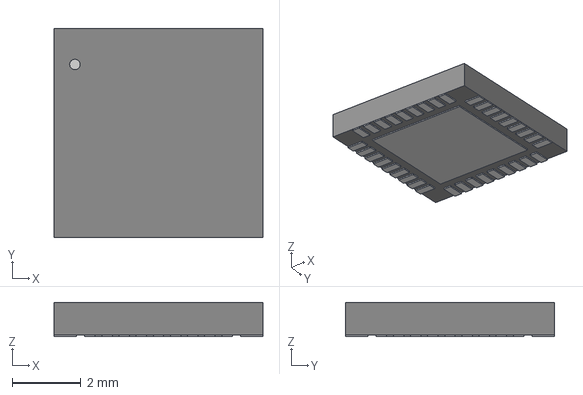
[picture p65: CAD file, 2025-07-31]
3dmodels/HVQFN36_SOT1092-2_NXP.step
6.10 x 6.10 x 0.993 mm
