NXPHoverGames/MR-KICAD-LIB/3dmodels/VL53L0X0.step

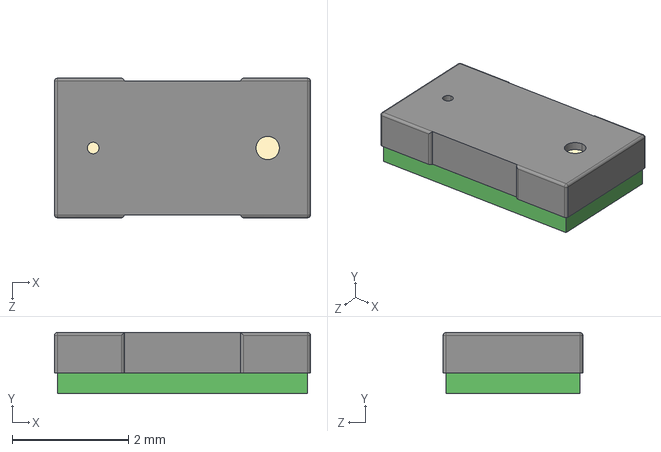
[picture p67: CAD file, 2025-07-31]
3dmodels/VL53L0X0.step
4.40 x 1.05 x 2.40 mm
