NXPHoverGames/MR-KICAD-LIB/3dmodels/MPM3811GG.step

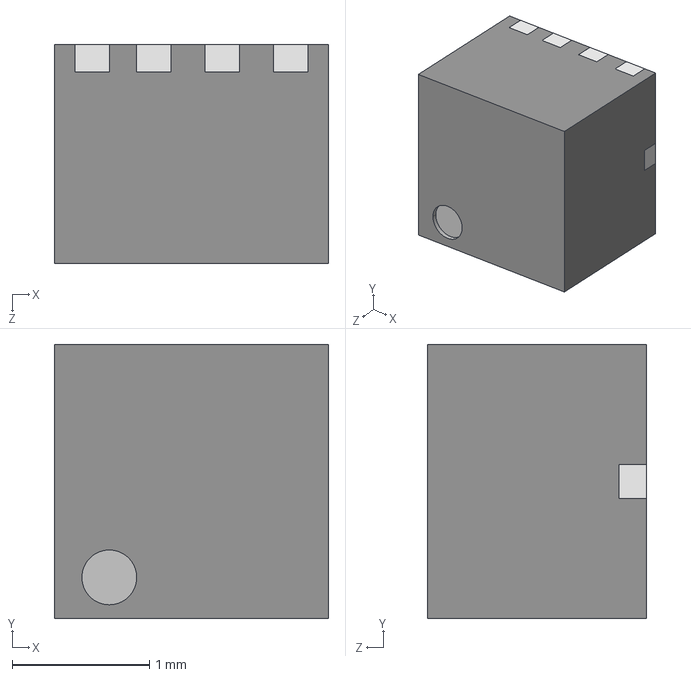
[picture p68: CAD file, 2025-07-31]
3dmodels/MPM3811GG.step
2.00 x 2.00 x 1.60 mm
