NXPHoverGames/MR-KICAD-LIB/3dmodels/DF40TC(2.5)-50DS-0.4V(51).stp

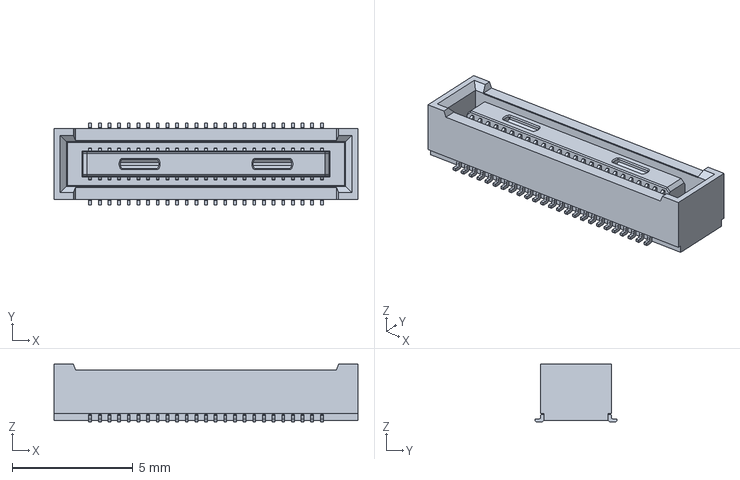
[picture p69: CAD file, 2025-07-31]
3dmodels/DF40TC(2.5)-50DS-0.4V(51).stp
12.6 x 3.38 x 2.40 mm
