NXPHoverGames/MR-KICAD-LIB/3dmodels/ESD7104MUTAG.stp

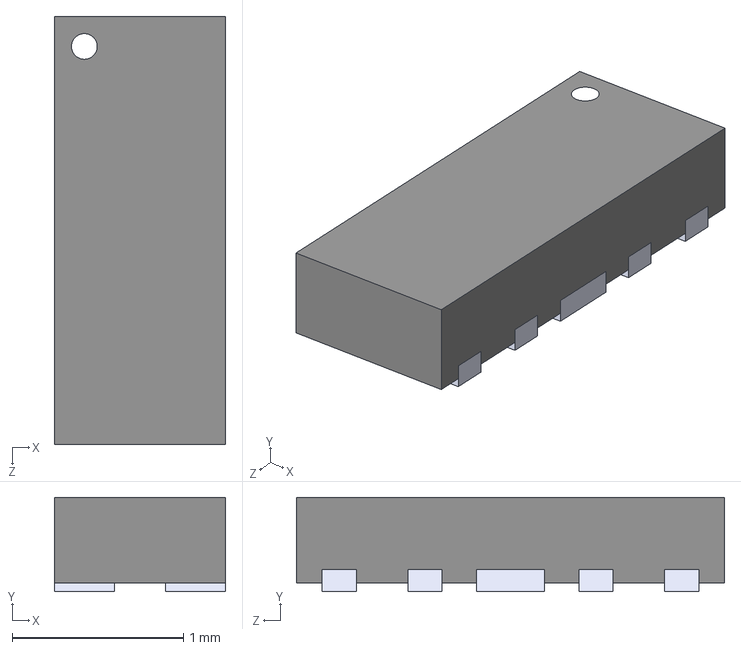
[picture p70: CAD file, 2025-07-31]
3dmodels/ESD7104MUTAG.stp
1.00 x 0.55 x 2.50 mm
