NXPHoverGames/MR-KICAD-LIB/3dmodels/ECS-480-8-33B-CWN-TR.stp

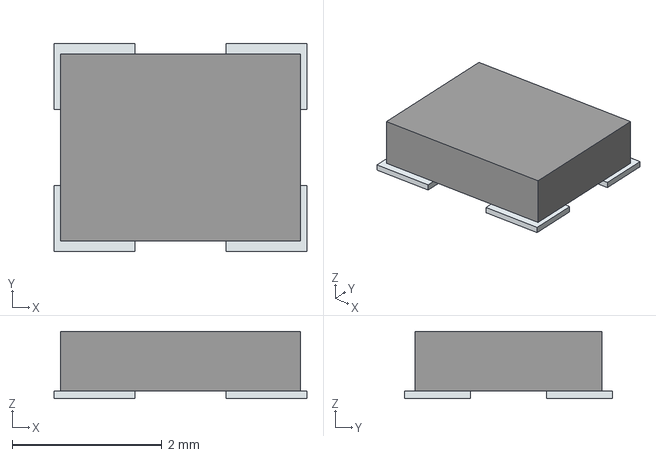
[picture p71: CAD file, 2025-07-31]
3dmodels/ECS-480-8-33B-CWN-TR.stp
3.38 x 2.78 x 0.9 mm
Pins
