NXPHoverGames/MR-KICAD-LIB/3dmodels/E-CHIP_D12.5_L13.5__NORMAL_COATED-CASE_STRUCTURE.stp

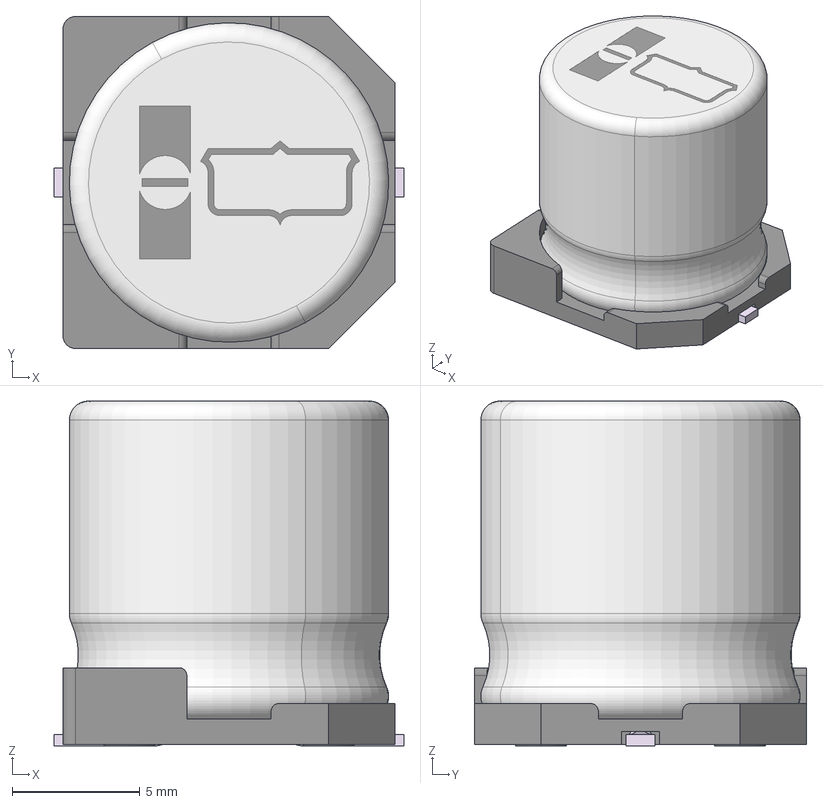
[picture p72: CAD file, 2025-07-31]
3dmodels/E-CHIP_D12.5_L13.5__NORMAL_COATED-CASE_STRUCTURE.stp
13.7 x 13.0 x 13.5 mm
E-CHIP_D12.5_LEAD+
E-CHIP_D12.5_LEAD-
E-CHIP_D12.5_TABLE
E-CHIP_D12.5_L13.5_ELEMENT
