NXPHoverGames/MR-KICAD-LIB/3dmodels/ICM-456860.step

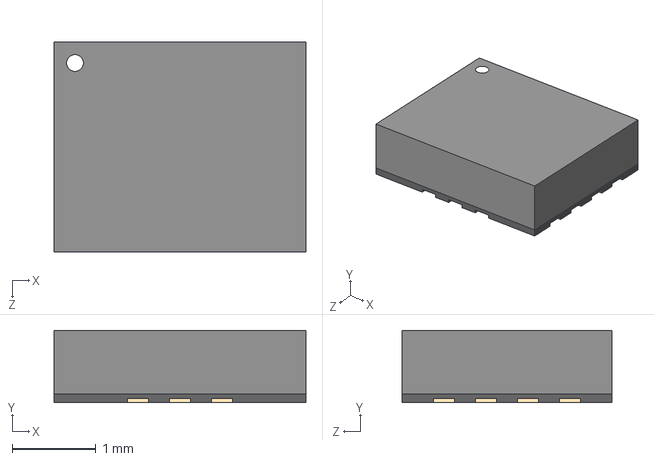
[picture p73: CAD file, 2025-07-31]
3dmodels/ICM-456860.step
3.00 x 0.86 x 2.50 mm
