NXPHoverGames/MR-KICAD-LIB/3dmodels/DF40C-30DP-0.4V_51_.stp

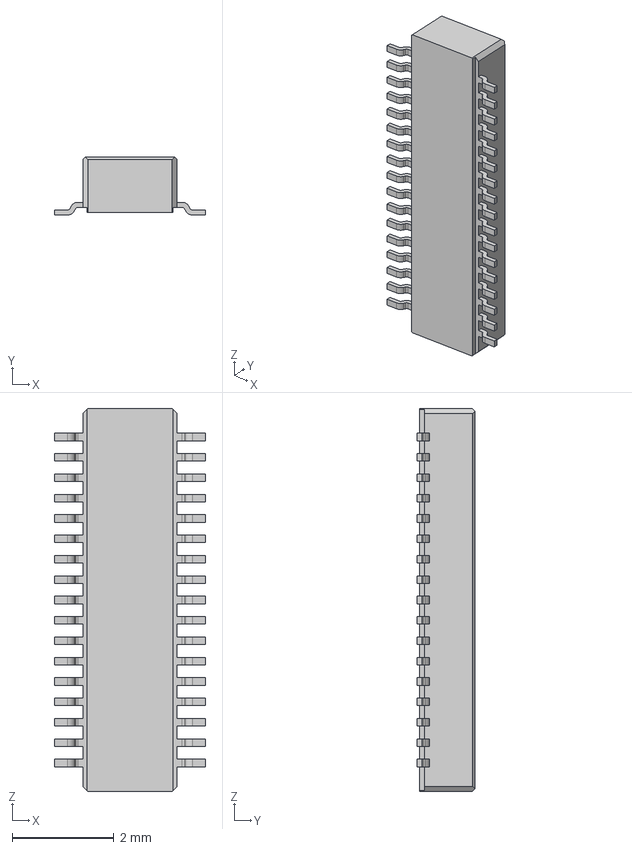
[picture p74: CAD file, 2025-07-31]
3dmodels/DF40C-30DP-0.4V_51_.stp
2.97 x 1.14 x 7.52 mm
