NXPHoverGames/MR-KICAD-LIB/3dmodels/IFLN1210BEER512N.stp

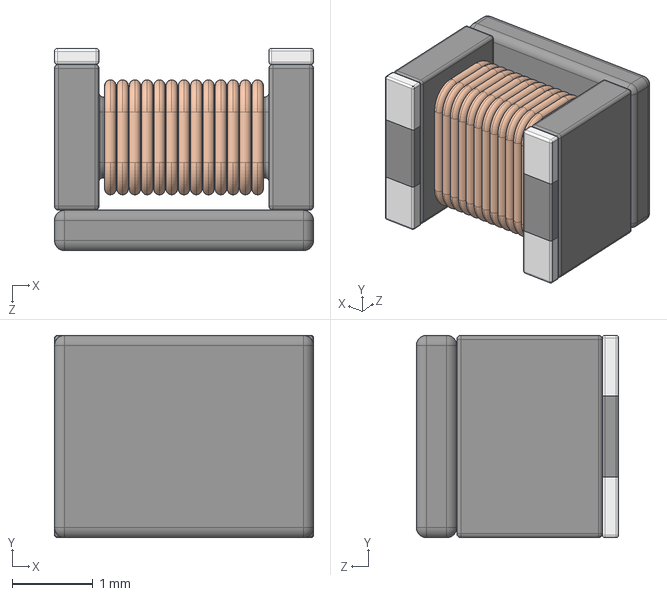
[picture p76: CAD file, 2025-07-31]
3dmodels/IFLN1210BEER512N.stp
3.20 x 2.50 x 2.50 mm
