NXPHoverGames/MR-KICAD-LIB/3dmodels/TJA1462ATK.stp

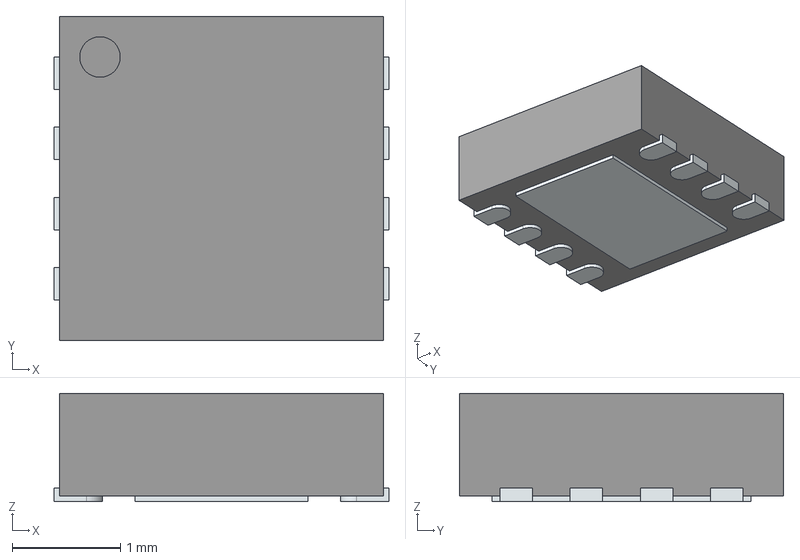
[picture p77: CAD file, 2025-07-31]
3dmodels/TJA1462ATK.stp
3.10 x 3.00 x 1.00 mm
ThermalPin
PinsArrayLR
