NXPHoverGames/MR-KICAD-LIB/3dmodels/VLS5045EX-330M-H.stp

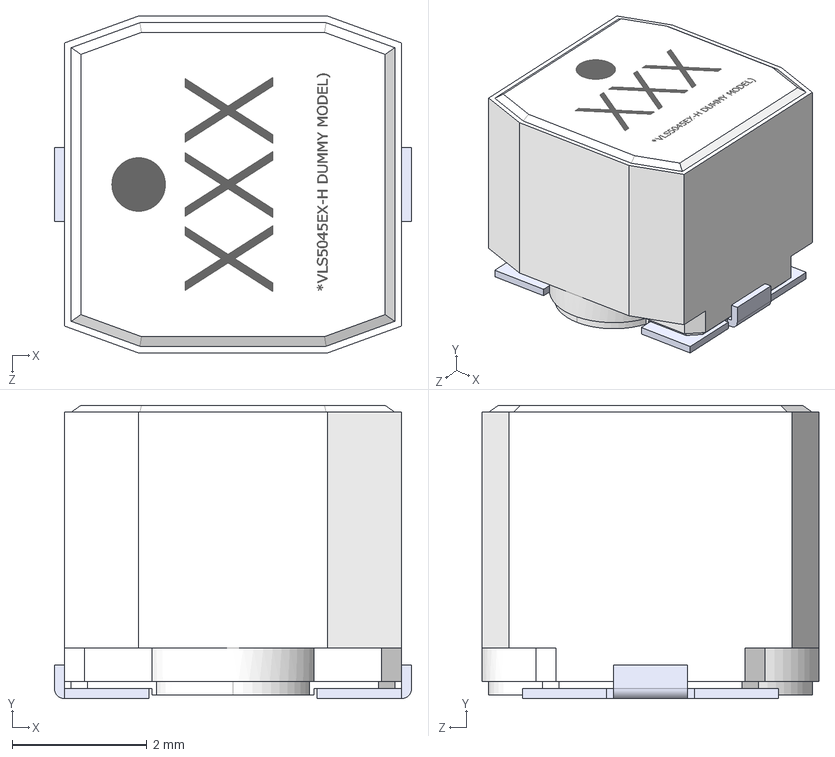
[picture p78: CAD file, 2025-07-31]
3dmodels/VLS5045EX-330M-H.stp
5.30 x 4.35 x 5.00 mm
VLS5045EX-H_C(3Dmodel)
VLS5045EX-H_T(3Dmodel)
