NXPHoverGames/MR-KICAD-LIB/(list of files, cad)

Other CAD files:
3dmodels/0430450223.stp
3dmodels/09452812800.stp
3dmodels/10029449-001RLF.STEP
3dmodels/10128796.stp
3dmodels/436500212.stp
3dmodels/436500412.stp
3dmodels/5055750421.stp
3dmodels/5055780271.stp
3dmodels/5055780421_micro-lock_plus_4p.stp
3dmodels/5055780471.stp
3dmodels/532610271.stp
3dmodels/691137710002.stp
3dmodels/74439369047.stp
3dmodels/757830132.stp
3dmodels/830108212309.stp
3dmodels/AP62600SJ-7.stp
3dmodels/LM66100DCKR.stp
3dmodels/MAX96724GTN_VY+.stp
3dmodels/SPM10065VT-2R2M-D.stp
