NXPHoverGames/MR-KICAD-LIB/(commit log)

2025-07-31 Initial commit
    - copied everything from previously used IND502 library repo
    [09452812800.stp, 1-1734248-5.stp, 10029449-001RLF.STEP, 10128796.stp, 10LGA_2X2X0p75_BOS.step, 21x21.960-21-21-D-AB-0.STEP, 436500212.stp, 436500412.stp]
2025-08-08 Added ADS127 ADC and Molex 2pins 53261D271
    [532610271.stp, ADS127L18IRSHT.stp]
2025-09-09 Added REF6041 and THS455
    [REF6041IDGKT.stp, THS4551IRGTR.stp]
2025-10-23 Added more parts
    - Added more JST-GH and JST-SH connector symbols
    - Added CHS-01TA dip switch
    - Added feedthrough cap NFM15PC104R1A3D
    - Added MOSFET NX138BKMYL
    - Updated TVS symbol group
    [CHS-01TA.STEP, NFM15PC104R1A3D.STEP, NX138BKMYL.STEP]
2025-11-24 Added JST-GH symbols
    - Added 2-pin to 10-pin JST GH right-angle and top-entry connector symbols
2026-07-27 Added P6SMB62CA part
    [P6SMB62CA.STEP]
2026-07-27 Added 0430450223 part
    [0430450223.stp]
