NXPHoverGames/MR-KICAD-LIB/(notices)

Notices in the files:
3dmodels/NANOT160AS.stp:
author */ ('License CC BY-ND 4.0'),
